Craos6518/AetherNet-IoT-Autonomous-Rover/docs/Estadistica/README.md

# Diario de Campo — Estadística (TS4D3)

> **Notebook:** `docs/Estadistica/notebook/EMA_Estadistica.ipynb` (canónico) · **Datasets:** `stats/Dataset/` (canónico 3.7 MB) ↔ `docs/Estadistica/Datasets/` (espejo) · **Análisis:** `stats/water_turbidity_analysis.py` + `stats/data/water_turbidity_report.json` · **Fritzing:** `docs/fritzing/AetherNet-P1-EMA-UNO-v1-breadboard.png`
> **Capa académica:** `docs/Estadistica/estadistica.md` (mapeo PDF TS4D3) + `docs/Estadistica/roadmap-estadistica.md` (búsquedas Google/datasheets) + `docs/Estadistica/backlog-estadistica.md` — este `docs/Estadistica/README.md` es el **diario de campo** (fotos/gráficos), no la teoría. Ver también `docs/Estadistica/Datasets/README.md` y `stats/Dataset/README.md`.

## Fotos / gráficos — checklist

- [ ] **EMA UNO breadboard** — ya existe `docs/fritzing/AetherNet-P1-EMA-UNO-v1-breadboard.png` + `ema-real-531.png`
- [ ] **Water US vs True** — ya existe `docs/fritzing/water_us_vs_true.png` (31.5k water_level_turbidity)
- [ ] **Water IR by Angle** — ya existe `docs/fritzing/water_ir_by_angle.png`
- [ ] **Alpha sweep 100×** — ya existe `docs/fritzing/alpha_sweep.png` (Monte Carlo `stats/experiments/alpha_sweep.py`)
- [ ] **KY-037 EMA** — `fotos/ky037-ema.png` — pendiente Sprint 4 (EST-03) — dejar `![GRAFICO PENDIENTE]`
- [ ] **T-Student boxplot** — `fotos/t-student-boxplot.png` — pendiente con datos PG reales Sprint 4

Si falta:

```markdown
![GRAFICO PENDIENTE](fotos/ky037-ema.png) — generar al cerrar EST-03 Sprint 4
```
