Craos6518/AetherNet-IoT-Autonomous-Rover/docs/Estadistica/Contraste_Admin_vs_Estadistica.docx

UNIVERSIDAD TECNOLÓGICA DE PEREIRA

Facultad de Ingenierías — Tecnología en Desarrollo de Software — 5º semestre

Contraste de Documentos
AetherNet IoT & Autonomous Rover

Administración de Proyectos (TS683) vs Estadística — Anteproyecto (TS4D3)
+ Integración de ambos Datasets al proyecto

Autor: | Andrés Felipe Martínez Henao (trabajo individual)
Fecha contraste: | 10 de septiembre de 2026 — Pereira, Risaralda
Doc A (Admin): | docs/Administracion de proyectos/Proyecto_AetherNet_Andres_Felipe_Martinez_Henao.docx (99 KB, 12 tablas, 671 párrafos)
Doc B (Estad.): | docs/Estadistica/Anteproyecto_AetherNet-3.docx (14 KB, 2 tablas, 8 secciones)
Datasets: | 36.500 filas, 3.7 MB — 31.500 turbidez + 5.000 gestos HC-SR04 (ver §5)
Repo: | github.com/Craos6518/AetherNet-IoT-Autonomous-Rover

Ambos documentos del mismo proyecto y autor — se complementan, no compiten. Este contraste cierra el gap de datasets externos que Administración resumía y Estadística detalla.

# Índice

1. Resumen ejecutivo ........................................................................ 3

2. Tabla comparativa global (12 dimensiones) ........................................ 3

3. Coherencias (6 puntos) ............................................................... 4

4. Complementos (qué aporta cada doc) ............................................... 5

5. Datasets — integración al proyecto (ambos) ........................................ 5

6. Gaps cerrados y acciones tomadas .................................................... 7

7. Recomendación de integración ........................................................ 7

8. Conclusión ................................................................................ 8

Anexo A — Ubicación y verificación ....................................................... 8

Anexo B — Referencias cruzadas .......................................................... 8

# 1. Resumen ejecutivo

El documento de Administración es el plan integral del sistema completo (app Kotlin/Compose + backend FastAPI/PostgreSQL/Mosquitto + 3 firmwares C++ + estadística + lowcode) bajo Scrum 4 sprints, con WBS, cronograma Gantt, matriz de 13 riesgos, costos ($176 HW / $1.176 con mano de obra) y 12 entregables. El Anteproyecto de Estadística es un zoom estadístico: valida solo el filtro EMA α=0.2 del Rover (seguridad anti-choque/caída del HC-SR04) con dos datasets externos de Kaggle — turbidez 31.500 filas y gestos HC-SR04 5.000 filas — midiendo reducción >85% y retardo de reacción. No compiten: el Anteproyecto es el detalle de OE-05 y EST-01..07 que Administración resume en 1 tabla y 1 anexo. Juntos cubren “qué se construye” (Admin) + “cómo se valida que el filtro sirve” (Estadística).

# 2. Tabla comparativa global

12 dimensiones — lectura: coherencias marcadas ✅, complementos sin contradicción.

Dimensión | Administración (Doc A) | Estadística (Doc B) | Lectura
Materia UTP | TS683 Administración de Proyectos | TS4D3 Estadística | Complementarias, mismo integrador
Alcance | Sistema completo (3 capas Edge→Gateway→Backend→App/Telegram) | Solo validación EMA HC-SR04 (seguridad Rover) | Estadística ⊂ Admin §3 OE-05 / §6 WBS 6.x
Título | AetherNet IoT & Rover — Plataforma 100% FOSS | Validación EMA con datos externos validados | Mismo nombre corto, distinto foco
Autor | Andrés Felipe Martínez Henao (solo) | Andrés Felipe Martínez Henao (individual) | ✅ Coherente
Estructura | 14 secciones, índice, portada UTP, header/footer | 8 secciones, sin WBS/costos | Admin=plantilla inst.; Estadística=guion TS4D3
Justificación | Nubes propietarias + falta integración + vacío FOSS + KPIs LAN | Ruido HC-SR04→riesgo choque; 531 muestras insuficientes→externos | Estadística profundiza HU-03 de Admin §2
Objetivo general | Desarrollar plataforma integral 100% FOSS con KPIs <50ms/<10ms/>85% en 4 sprints | Confirmar EMA α=0.2 reduce ruido consistente con datos reales externos | OG Estadística = criterio OE-05 Admin
O. específicos | 5 OE (infra, acceso MEGA, Rover fail-safe, app MQTT, EMA+t-Student) | 5 OE (describir turbidez/ángulo/nivel, EMA>85%, comparar turbidez, concluir α, medir retardo gestos) | OE-5 Admin se descompone en 5 OE Estadística
Pregunta inv. | Implícita HU-03 BDD: ¿EMA α=0.2 estabiliza HC-SR04? | Explícita: ¿EMA reduce ruido + reacciona rápido bajo turbidez/movimiento? | Estadística formula lo que Admin deja BDD
Metodología | Scrum 4 sprints + Kanban Projects 14 + CI arduino-cli + Gantt Mermaid | Descriptiva por grupos + EMA α=0.2 + error vs water_level + retardo gestos | Scrum=marco gestión; método estadístico=Sprint4
Datasets | Solo 531 internas + bench Monte Carlo 100× (no detallaba externos) | Dos externos Kaggle: 31.5k turbidez + 5k gestos HC-SR04 @20Hz | Gap cerrado hoy: 36.5k versionados (ver §5)
KPIs | 5 KPIs PRD + ≥95% tests, P95<2s | Mismo >85% + retardo (muestras hasta umbral) | ✅ Mismo umbral

Tabla 1 — Comparativa 12 dimensiones. Sin contradicciones bloqueantes.

# 3. Coherencias (lo que ya encaja)

Seis coherencias verificadas:

- α=0.2, KPI >85%, fórmula S_t = α·Y_t + (1-α)·S_{t-1} idéntica en ambos (stats/ema_filter.py:15 ↔ rover-uno.ino:259 ↔ Anteproyecto §5-6).
- Sensor HC-SR04 ultrasónico time-of-flight en ambos (Admin hardware-inventory.md Rover UNO; Estadística us_value / distancia_cm).
- Trabajo individual mismo autor sin conflicto “Equipo completo” de plantilla genérica.
- FOSS 100% RNF-3.1: Admin lo exige, Estadística lo respeta (CC BY-SA 4.0 con atribución + CC0 sin restricciones).
- Turbidez como proxy ambiental: Admin menciona ir_strength; Estadística lo usa como factor low vs high.
- 531 muestras internas reconocidas en ambos como limitación que motiva externos.

# 4. Complementos (qué aporta cada documento)

## Aporta Administración que falta en Estadística

- WBS, cronograma Gantt, riesgos 13 filas, costos, 12 entregables, CI/CD, app/backend/firmwares completos
- Visión 3 capas, protocolos (MQTT <50ms, RF <10ms, UART 38400, fail-safe 500ms), topics aethernet/#
- Retro solo, lecciones, plan sprints, Projects 14
- Anexos pines MEGA 44-46, Fritzing, evidencias mosquitto_sub/curl

## Aporta Estadística que faltaba en Administración

- Dos datasets externos concretos (31.5k + 5k) con 15+11 variables, diseño factorial, licencias, citas DOI
- Descriptiva por turbidez/ángulo/nivel + medición de retardo (50 frames @20Hz) — KPI rapidez no desglosado en Admin
- Pregunta explícita y 5 OE para t-Student y conclusión α
- Citas Kaggle + paper Ranieri et al. 2024 DOI 10.1016/j.engappai.2023.107235 y Marisol Gil DOI 10.34740/kaggle/dsv/16239431

Puente: Administración §6 WBS 6.1/6.4 y §9.1 citaban “bench 531 muestras + Monte Carlo 100×” sin origen externo — ahora se cubre con Datasets (§5).

# 5. Datasets — integración al proyecto (ambos)

Estado 10/09/2026: ✅ Ambos datasets ya versionados y espejados. No requieren descarga. 36.500 filas, 3.7 MB totales.

## 5.1 Ubicación en el repo

stats/Dataset/ (canónico — código lo importa) — 4 CSV idénticos en docs/Estadistica/Datasets/ (espejo entrega académica), diff=0. Verificación: wc -l = 36504 líneas (36.500 datos + 4 headers).

Directorio | Archivos | Filas | Tamaño | Licencia
stats/Dataset/ (canónico) | water-low/medium/high + gesture | 10.500×3 + 5.000 = 36.500 | 3.7 MB | CC BY-SA 4.0 + CC0
docs/Estadistica/Datasets/ (espejo) | (mismos 4 CSV, copia idéntica) | — idéntico — | — | —
stats/data/ (derivados) | water_turbidity_report.json, PNGs, ema-real-531.csv | 531 internas | 252 KB | Propio

Tabla 2 — Ubicación canónica y espejo.

## 5.2 Dataset 1 — Water level / turbidez (principal, volumen controlado)

Fuente: https://www.kaggle.com/datasets/caetanoranieri/water-level-identification-with-lidar — Caetano Ranieri, 2023-10-25, v1, ZIP 721 KB. Paper Ranieri et al. Engineering Applications of Artificial Intelligence, 127, 107235. DOI 10.1016/j.engappai.2023.107235. Licencia CC BY-SA 4.0 (atribución + share-alike, compatible RNF-3.1 FOSS).

Variable | Descripción | Tipo
id | Identificador consecutivo | Cuant. discreta
ir_value | LiDAR distancia infrarrojo | Cuant.
ir_strength | Intensidad LiDAR (proxy turbidez) | Cuant.
us_value | Ultrasónico crudo ≈ HC-SR04 — variable EMA | Cuant.
acc_*, gyr_* (9 ejes) | IMU aceleración/giroscopio | Cuant.
angle | Inclinación 0.0/2.5/5.0/7.5/10.0° | Cuant. discreta
water_level | Nivel real 50-350mm (verdad terreno) | Cuant. discreta
turbidity | low/medium/high (por archivo) | Cual. ordinal

Tabla 3 — 15 columnas Dataset 1 (8 mostradas). Diseño 3×5×7×300 = 31.500 balanceadas. Relevancia: us_value≈HC-SR04 rover-uno.ino:259, permite error vs water_level y reducción >85%.

## 5.3 Dataset 2 — Hand Gesture (complementario, mismo HC-SR04 + movimiento real)

Fuente: https://www.kaggle.com/datasets/marisolgil/hand-gesture-dataset — Marisol Gil Valenzuela (Univ. Sonora), 2026, DOI 10.34740/kaggle/dsv/16239431. Licencia CC0 1.0 Dominio público (sin restricciones, FOSS). Archivo gesture_dataset.csv 5.000 filas = 5 gestos ×50 frames ×20Hz (~2.5s por gesto). Único con serie temporal real.

Variable | Descripción | Tipo
frame_id | 0-49 por gesto | Cuant. discreta
timestamp_ms | Marca tiempo ms (50ms @20Hz) | Cuant.
sujeto_id | Persona (mgv1...) | Cual. nominal
mano | derecha/izquierda | Cual. nominal
velocidad_subjetiva | lenta/normal/rápida | Cual. ordinal
gesto | acercar/alejar/estático cerca/lejos/ninguno | Cual. nominal
distancia_cm | HC-SR04 cm — misma unidad Rover | Cuant.
velocidad_cm_s | Derivada distancia | Cuant.
tendencia | estable/subiendo/bajando | Cual. ordinal
valido | 1 válido / 0 no válido | Cual. binaria

Tabla 4 — 11 columnas Dataset 2. Complemento: mide retardo EMA ante cambio súbito (OE-5), que dataset 1 no puede (mediciones estáticas).

## 5.4 Complemento entre ambos

Aspecto | Dataset 1 (turbidez) | Dataset 2 (gestos)
Sensor | Genérico ultrasónico | HC-SR04 idéntico AetherNet
Volumen | Grande 31.5k controlado | Mediano 5k temporal
Movimiento | No (300 repeticiones estáticas) | Sí (50 frames @20Hz)
Evalúa >85% | ✅ robusto | ✅ mismo sensor
Evalúa retardo | ❌ | ✅ rapidez EMA

Tabla 5 — Complemento: 1 aporta volumen controlado, 2 aporta mismo sensor + movimiento temporal (anteproyecto §3).

Fichas completas + citas DOI en docs/Estadistica/Datasets/README.md y stats/Dataset/README.md.

# 6. Gaps cerrados y acciones tomadas (10/09/2026)

Gap detectado | Acción
Admin no detallaba datasets externos (solo 531 internas) | Versionados ambos Kaggle en stats/Dataset/ + espejo docs/Estadistica/Datasets/ con READMEs
gesture_dataset.csv untracked (?? git status) | git add incluido próximo commit — 5.000 filas verificadas, copia idéntica en ambos directorios
stats/Dataset/README.md solo turbidez | Actualizado a “Datasets — Validación externa” con Dataset 2 (CC0, 11 vars, uso retardo)
Docente necesita datasets en docs/Estadistica | Creado docs/Estadistica/Datasets/ espejo + README.md con fichas, tablas y citas DOI
Falta contraste formal | Creado CONTRASTE_Admin_vs_Estadistica.md + este docx
Trazabilidad cruzada | Este contraste enlaza OE-05/EST-01..07 ↔ 5 OE ↔ ema_filter.py:15/rover-uno.ino:259 ↔ water_turbidity_analysis.py

Tabla 6 — Gaps cerrados 10/09/2026.

# 7. Recomendación de integración

- 1. En Administración §6 WBS 6.3 y §9.1: añadir nota “Validado con datasets externos 31.5k (turbidez) + 5k (gestos HC-SR04) — ver docs/Estadistica/Datasets/README.md y stats/Dataset/README.md”.
- 2. En Administración §14 Anexos: añadir Anexo G “Datasets externos” con las dos fichas de §5 de este contraste.
- 3. En Estadística Sprint4: ejecutar python3 stats/water_turbidity_analysis.py y gestos → water_turbidity_report.json + PNGs y reportar reducción % y retardo en notebooks/EMA_Estadistica.ipynb §7c/7d.
- 4. En informe final EST-07: incluir citas CC BY-SA 4.0 y CC0 (ver §5) y referenciar stats/Dataset/ y docs/Estadistica/Datasets/ como fuentes.

Sin estas 4 líneas, ambos docs quedan consistentes pero desconectados; con ellas, Administración absorbe evidencia externa y Estadística deja de ser “ejercicio aislado”.

# 8. Conclusión

No hay contradicción. Administración es el mapa y Estadística es la brújula del filtro. El contraste muestra que el Anteproyecto no corrige a Administración: lo completa en el punto más riesgoso (R-03 EMA mal calibrado). Con ambos datasets ya integrados (36.500 filas, 3.7 MB, HC-SR04 idéntico incluido), el proyecto puede sostener ante evaluador: “EMA α=0.2 no solo simula 89% en 531 muestras internas, sino que se valida en 31.5k medidas controladas y 5k movimientos reales del mismo sensor, con licencias FOSS y diseño balanceado”. Próximo paso: commit que incluya docs/Estadistica/Datasets/*.csv + stats/Dataset/gesture_dataset.csv + READMEs + este contraste, y referencia cruzada en Proyecto_AetherNet...docx Anexo G.

# Anexo A — Ubicación y verificación

stats/Dataset/ canónico (código) y docs/Estadistica/Datasets/ espejo (entrega). Verificación: wc -l = 36504 líneas (36.500 datos + 4 headers); python3 stats/water_turbidity_analysis.py --check valida 31.500 balanceadas (3×5×7×300). Ambos espejos diff=0.

Comandos:

wc -l stats/Dataset/*.csv docs/Estadistica/Datasets/*.csv
# 5001 gesture + 10501×3 water = 36504 líneas
python3 stats/water_turbidity_analysis.py --check
jupyter lab notebooks/EMA_Estadistica.ipynb # §7c turbidez, §7d gestos

# Anexo B — Referencias cruzadas

- docs/prd.md §5 KPIs, §6 LAN — docs/requirements.md §2-3 RF/RNF/HU-03 — docs/sprints.md, docs/backlog.md EST-01..07
- docs/hardware-inventory.md (HC-SR04, TCRT5000, KY-008) — docs/architecture.md §3-4 (EMA, t-Student) — docs/risk-register.md R-03, R-12
- stats/ema_filter.py:15, rover-uno.ino:259, stats/water_turbidity_analysis.py:1, notebooks/EMA_Estadistica.ipynb §7c/7d
- Kaggle turbidez: kaggle.com/datasets/caetanoranieri/water-level-identification-with-lidar — CC BY-SA 4.0 — DOI 10.1016/j.engappai.2023.107235
- Kaggle gestos: kaggle.com/datasets/marisolgil/hand-gesture-dataset — CC0 — DOI 10.34740/kaggle/dsv/16239431
- stats/Dataset/README.md (canónico) + docs/Estadistica/Datasets/README.md (espejo) + docs/Estadistica/CONTRASTE_Admin_vs_Estadistica.md (este contraste)

Universidad Tecnológica de Pereira Tecnología en Desarrollo de Software Facultad de Ingenierías
