Craos6518/AetherNet-IoT-Autonomous-Rover/docs/fritzing/AetherNet-P1-EMA-UNO-v1-breadboard.png

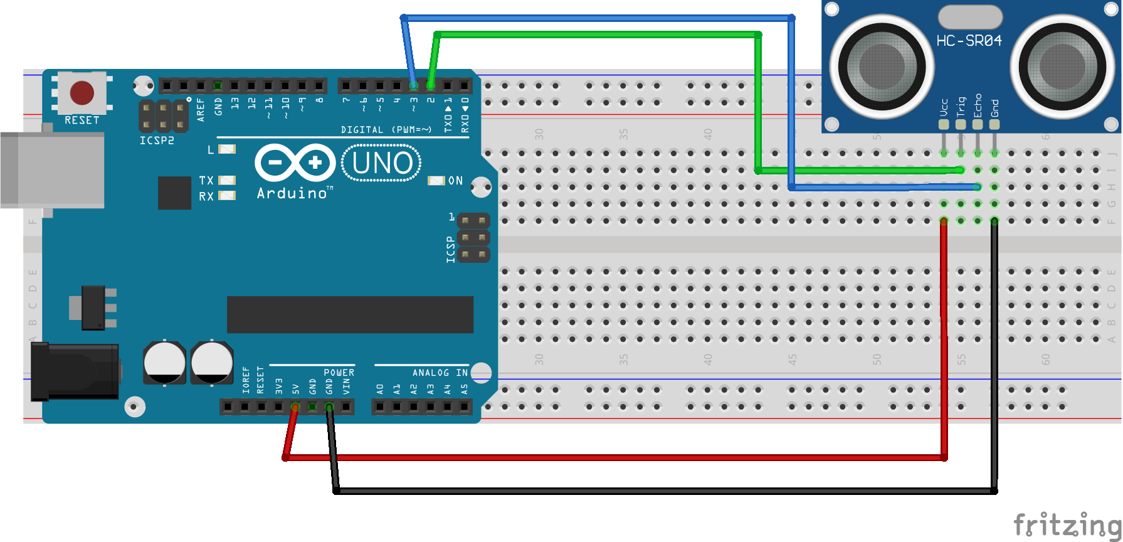
docs/fritzing/AetherNet-P1-EMA-UNO-v1-breadboard.png
