Craos6518/AetherNet-IoT-Autonomous-Rover/docs/fritzing/AetherNet-P2-RF-Link-v1-breadboard.png

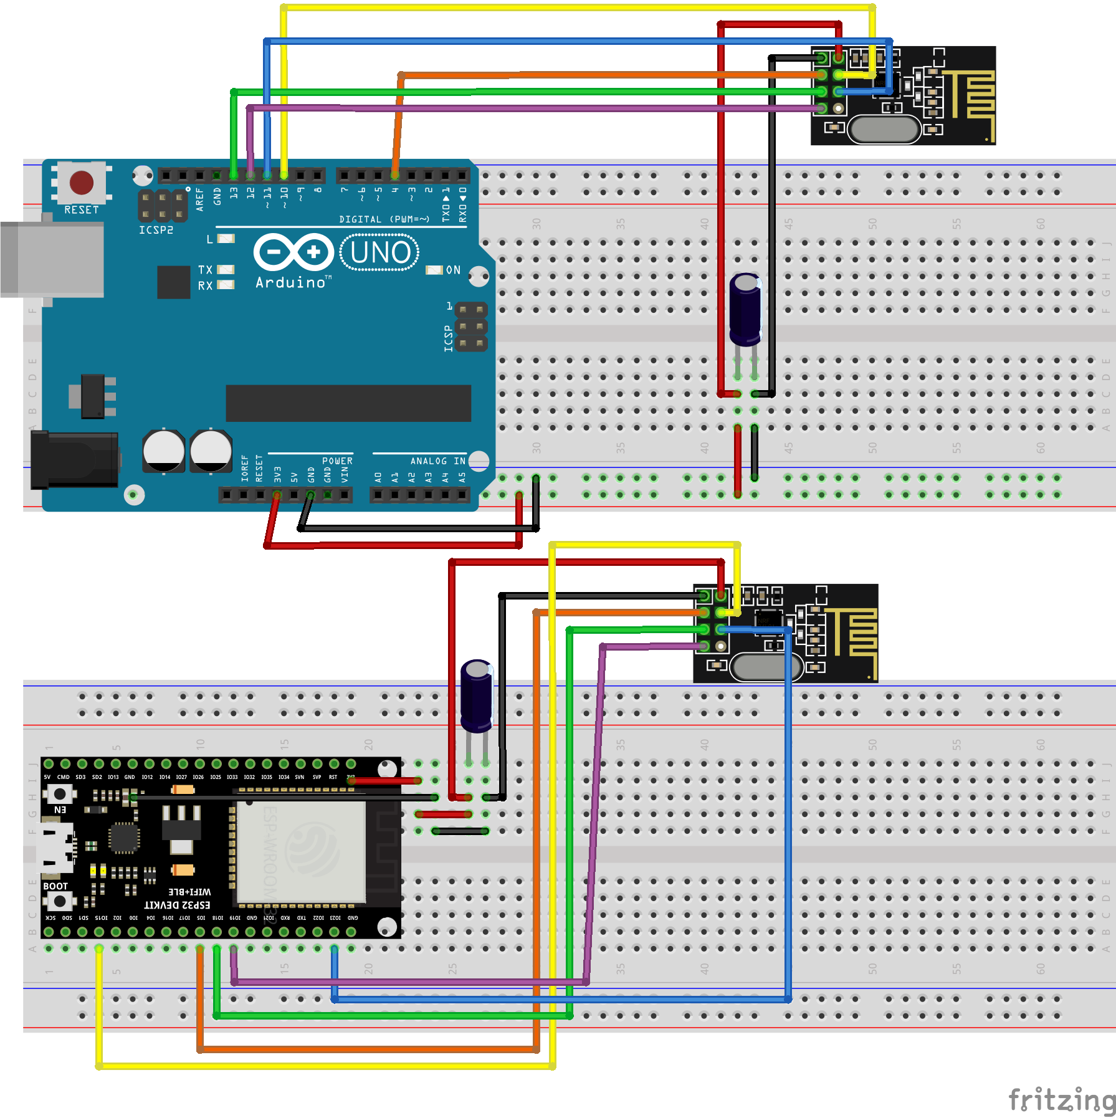
docs/fritzing/AetherNet-P2-RF-Link-v1-breadboard.png
