Craos6518/AetherNet-IoT-Autonomous-Rover/docs/fritzing/AetherNet-P3-MEGA-Cerrojo-v1-breadboard.png

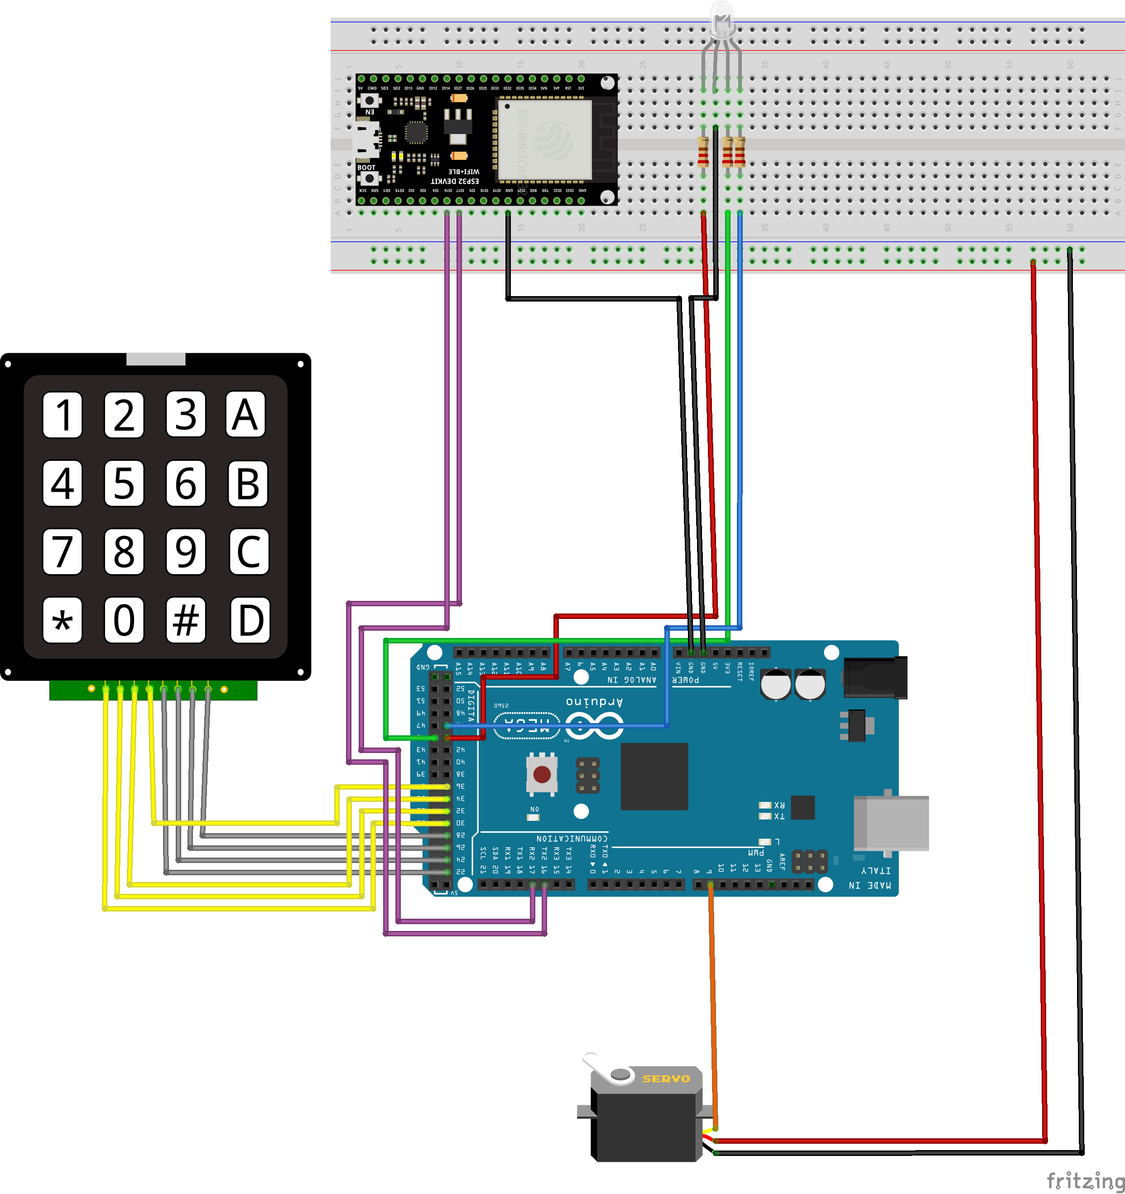
docs/fritzing/AetherNet-P3-MEGA-Cerrojo-v1-breadboard.png
