Craos6518/AetherNet-IoT-Autonomous-Rover/docs/fritzing/AetherNet-P4-Rover-v1-breadboard.png

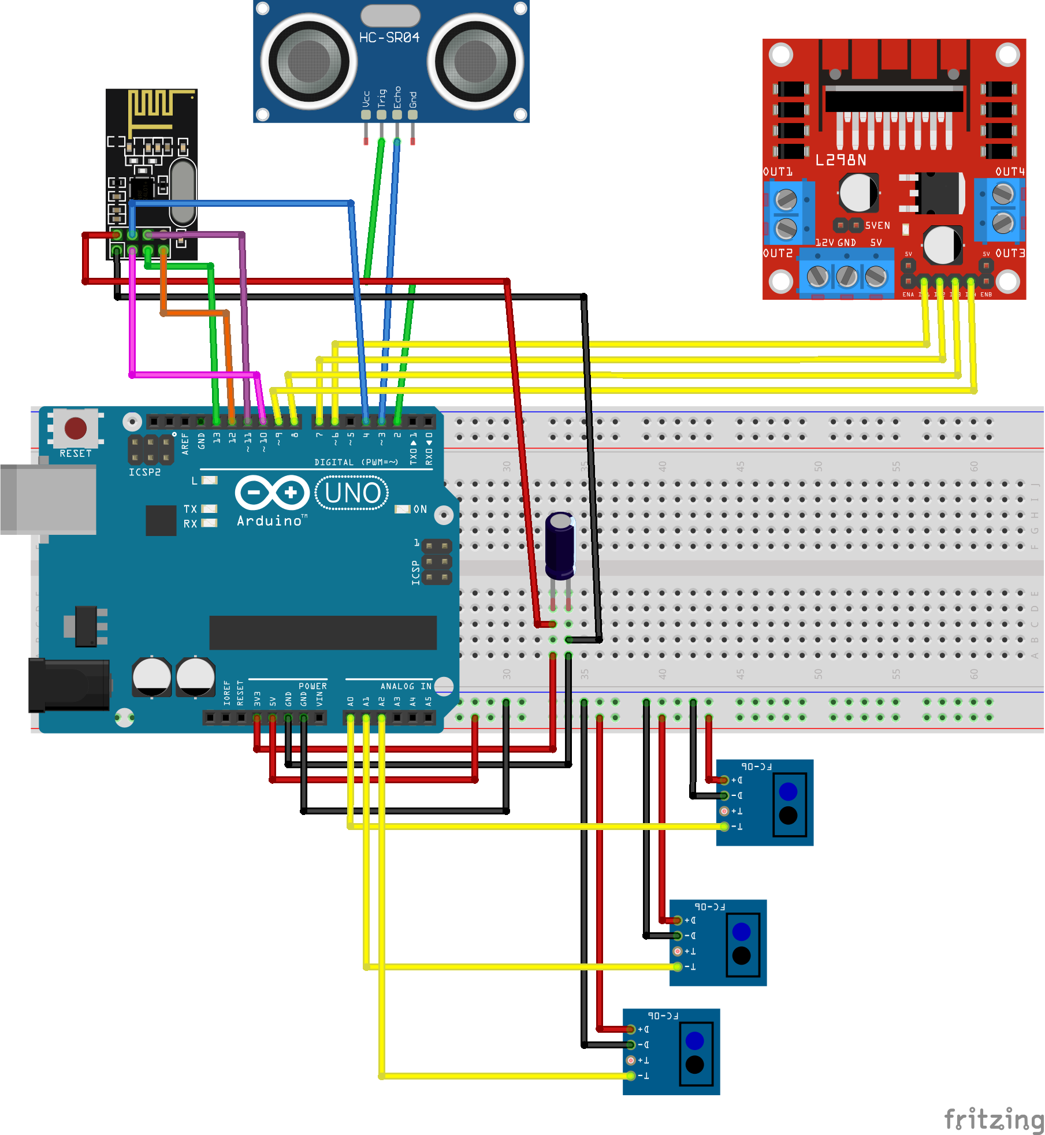
docs/fritzing/AetherNet-P4-Rover-v1-breadboard.png
