Craos6518/AetherNet-IoT-Autonomous-Rover/docs/fritzing/AetherNet-P5-Laser-v1-breadboard.png

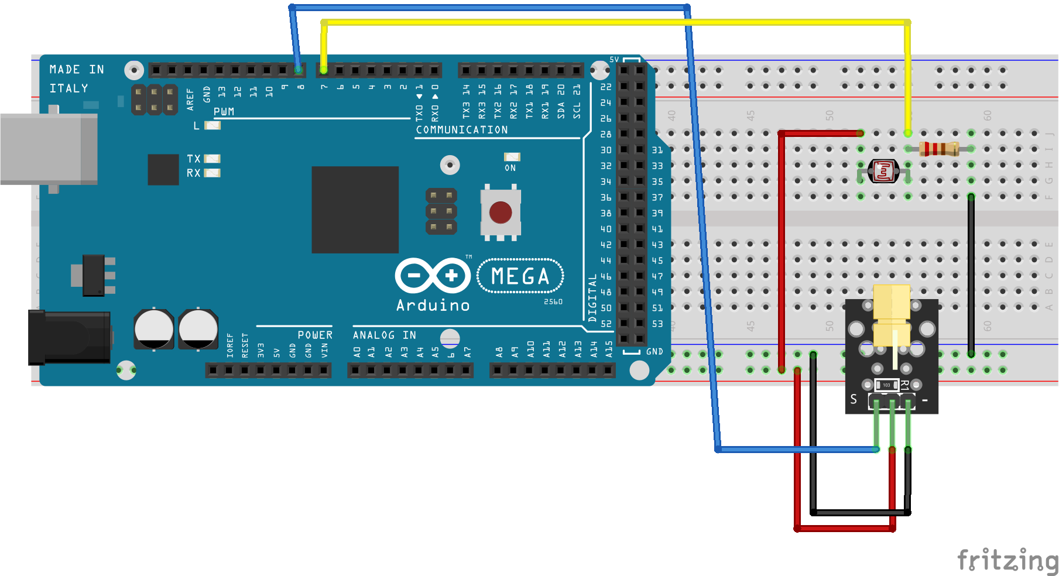
docs/fritzing/AetherNet-P5-Laser-v1-breadboard.png
