Craos6518/AetherNet-IoT-Autonomous-Rover/docs/fritzing/AetherNet-P6-Ambiental-v1-breadboard.png

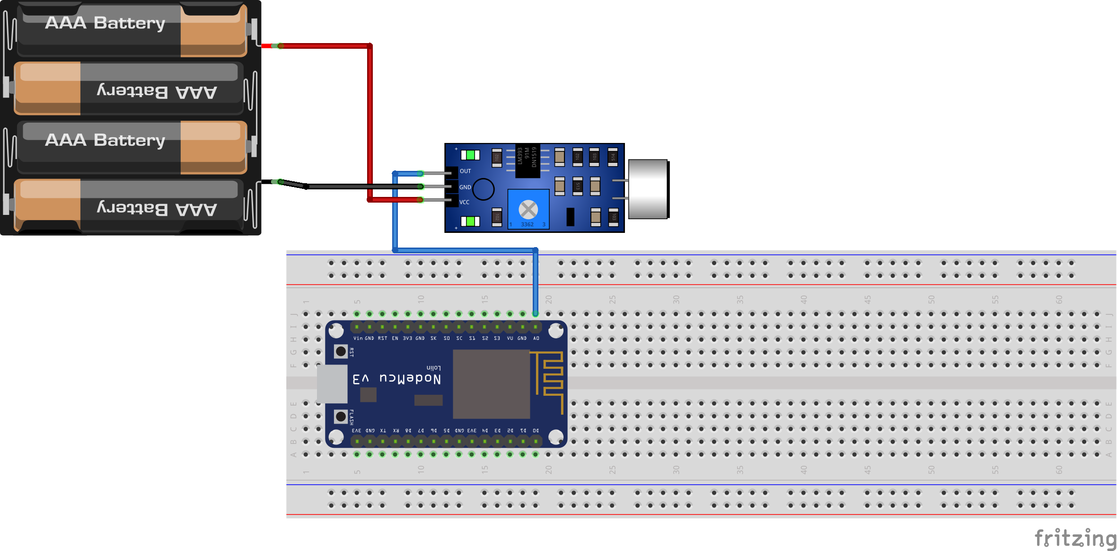
docs/fritzing/AetherNet-P6-Ambiental-v1-breadboard.png
