Craos6518/AetherNet-IoT-Autonomous-Rover/docs/fritzing/AetherNet-P7-Compacto-v1-breadboard.png

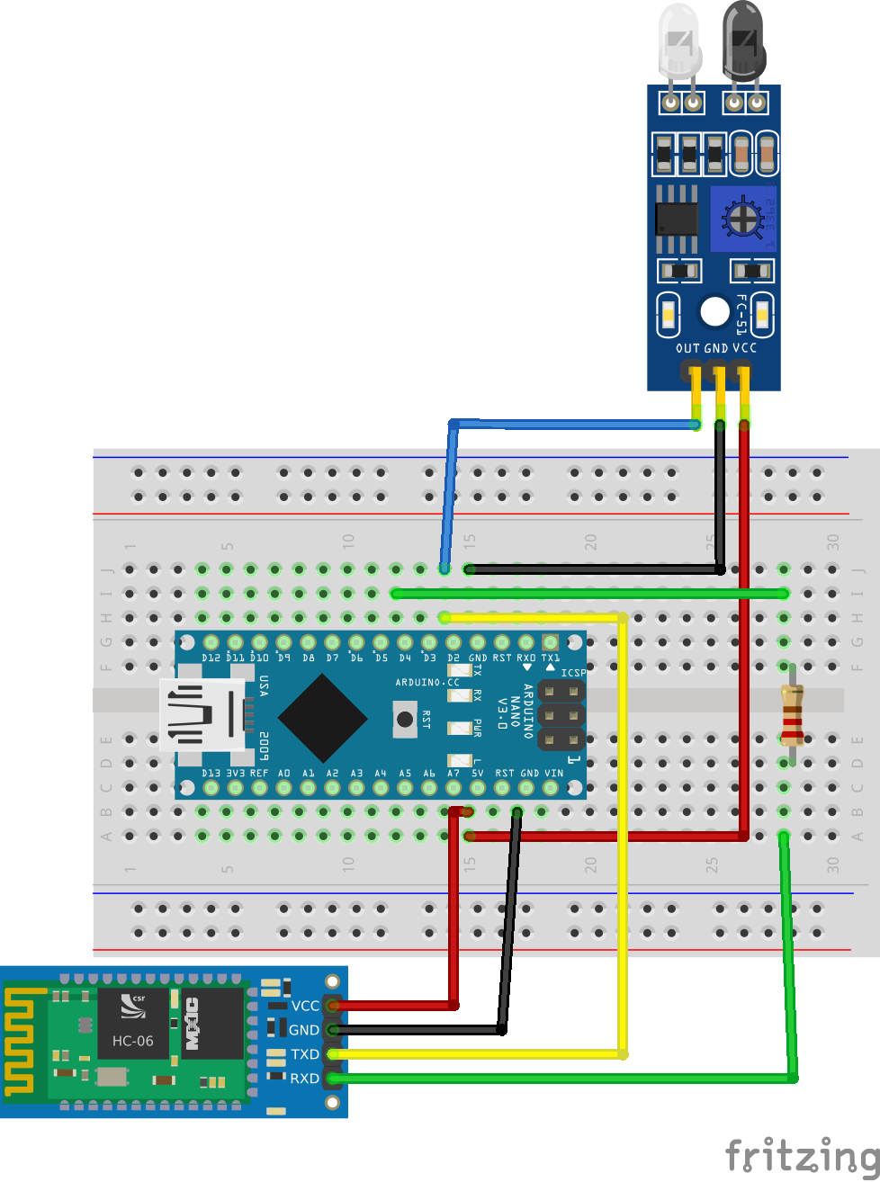
docs/fritzing/AetherNet-P7-Compacto-v1-breadboard.png
