Craos6518/AetherNet-IoT-Autonomous-Rover/docs/fritzing/alpha_sweep.png

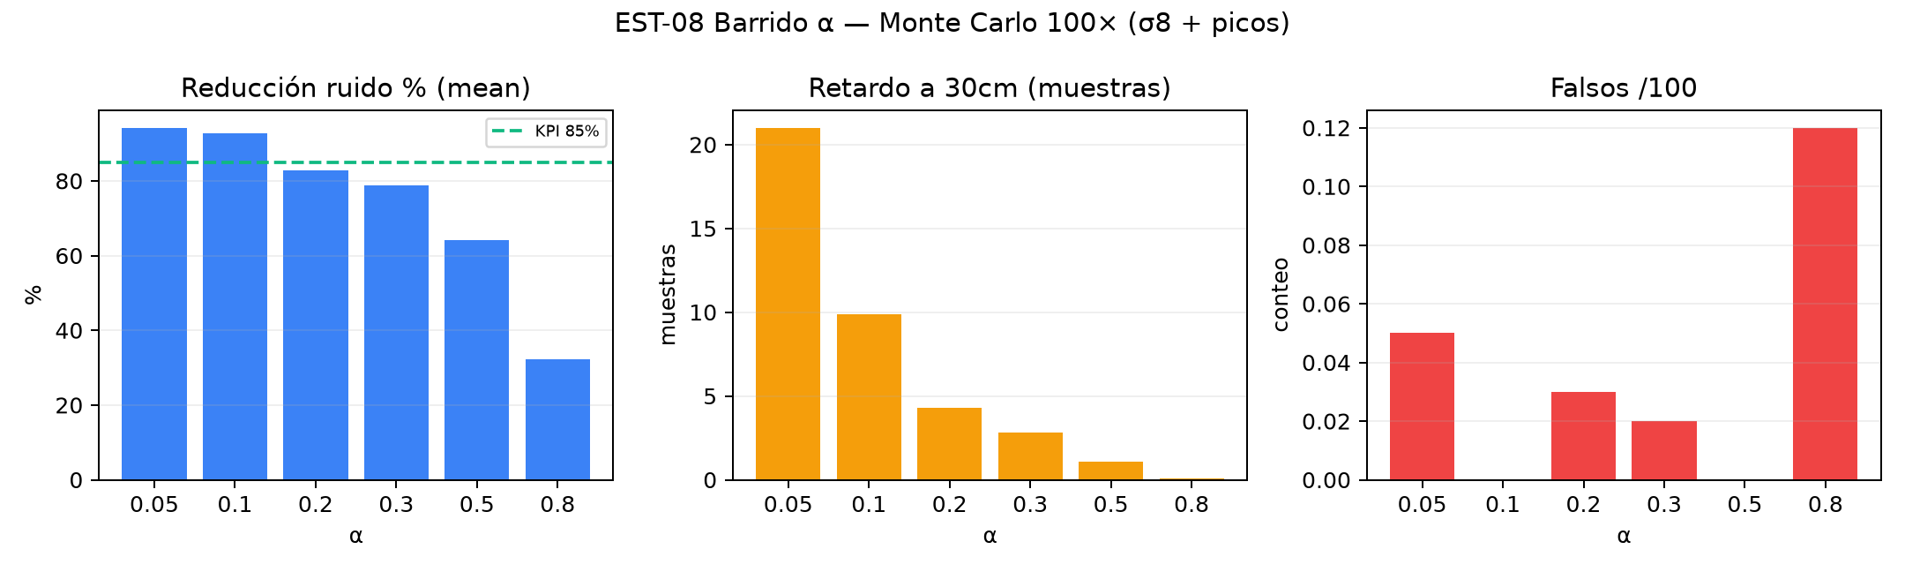
docs/fritzing/alpha_sweep.png
