Craos6518/AetherNet-IoT-Autonomous-Rover/docs/fritzing/ema-compare.png

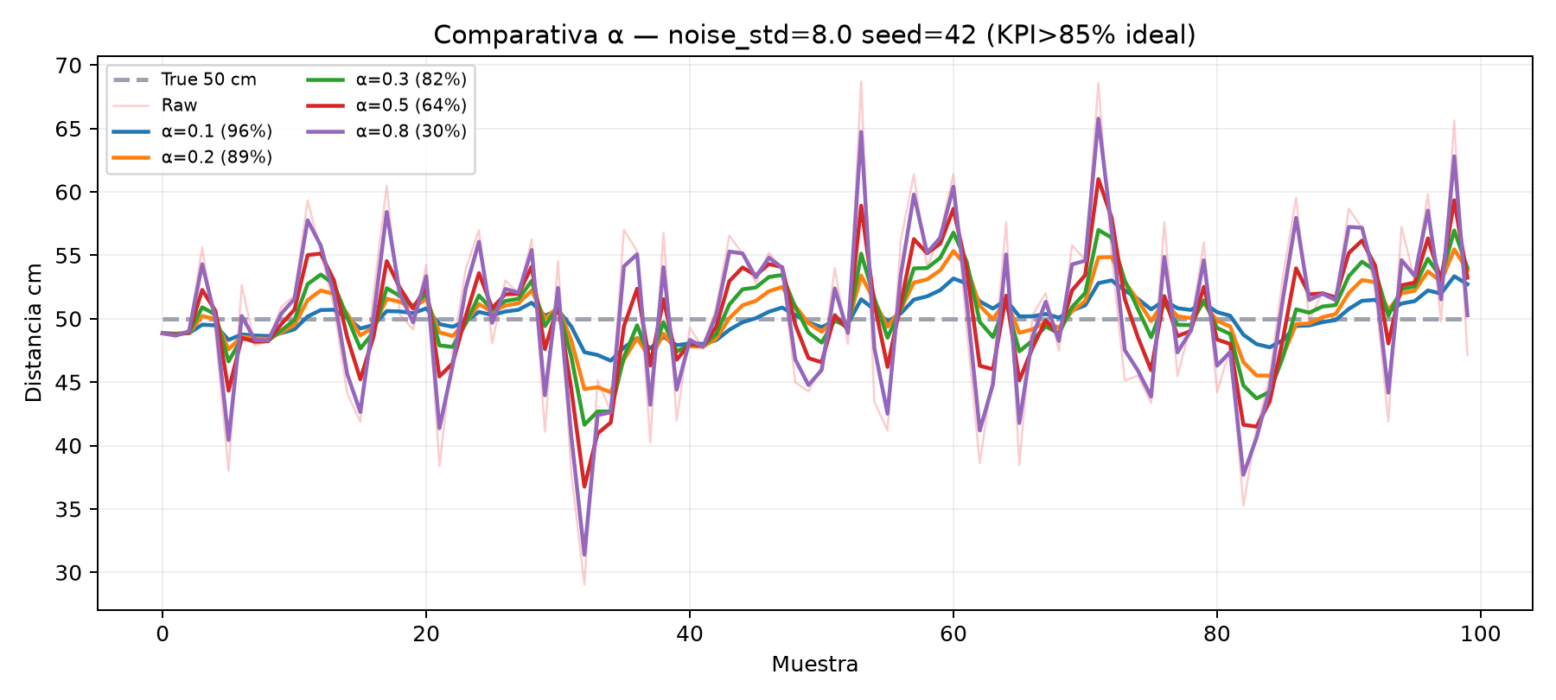
docs/fritzing/ema-compare.png
