Craos6518/AetherNet-IoT-Autonomous-Rover/docs/fritzing/ema-demo.png

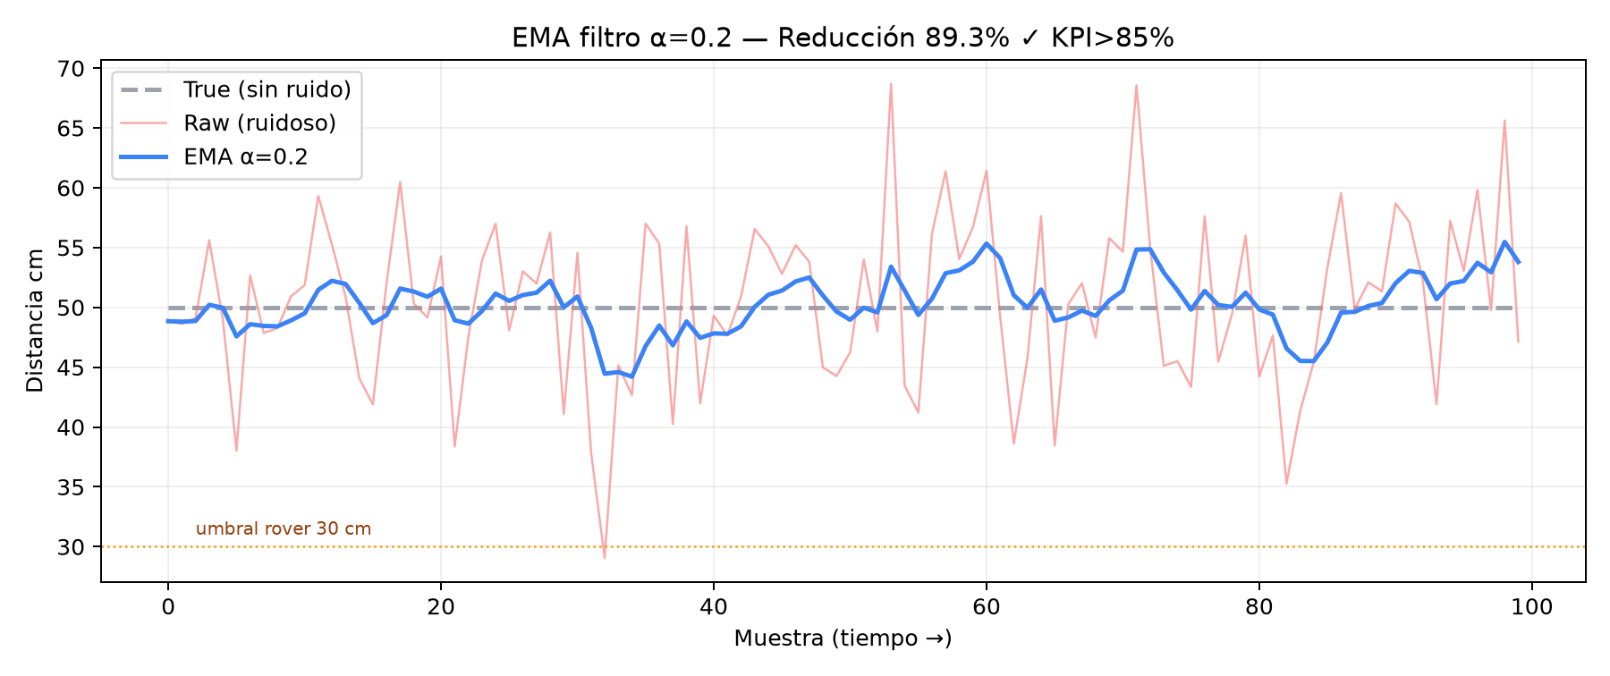
docs/fritzing/ema-demo.png
