Craos6518/AetherNet-IoT-Autonomous-Rover/docs/fritzing/ema-obstacle.png

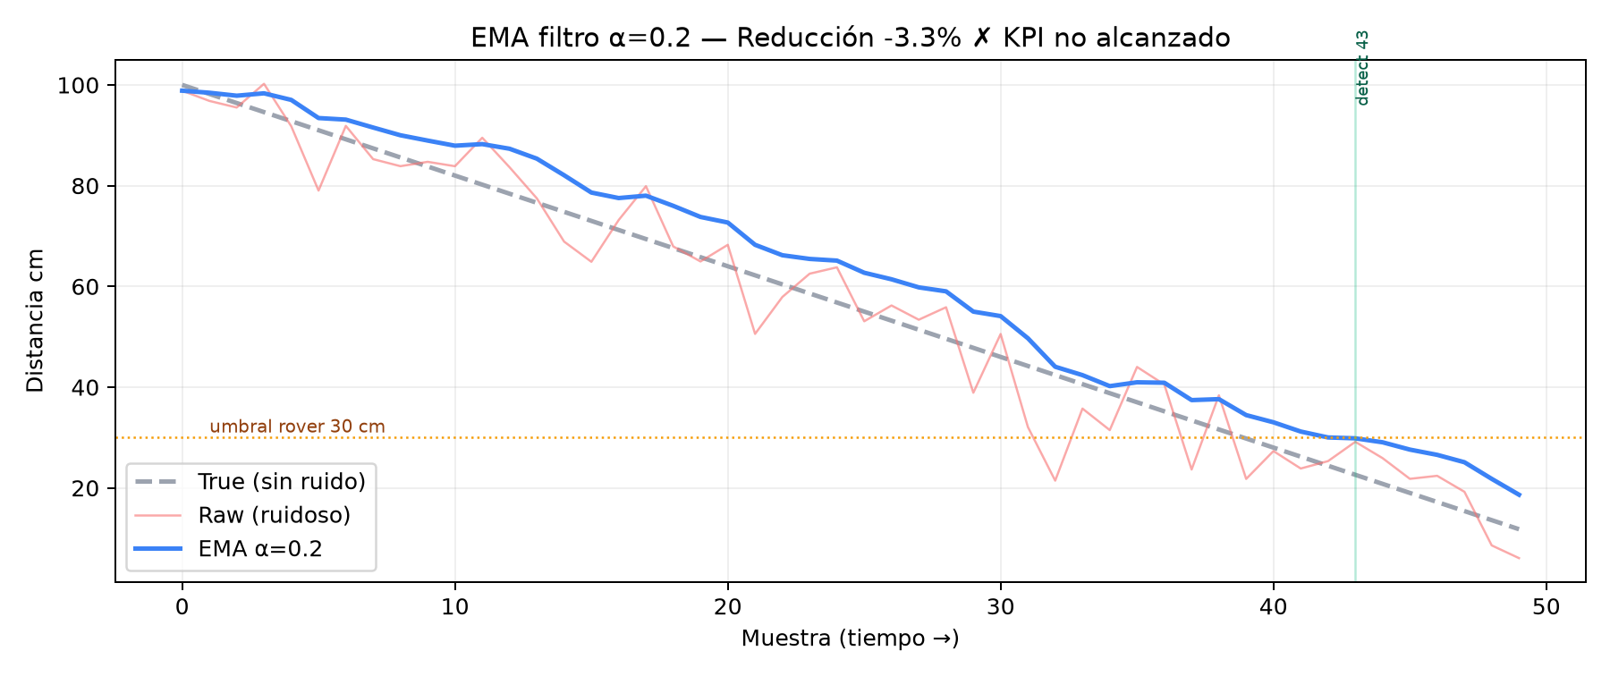
docs/fritzing/ema-obstacle.png
