Craos6518/AetherNet-IoT-Autonomous-Rover/docs/fritzing/ema-real-531.png

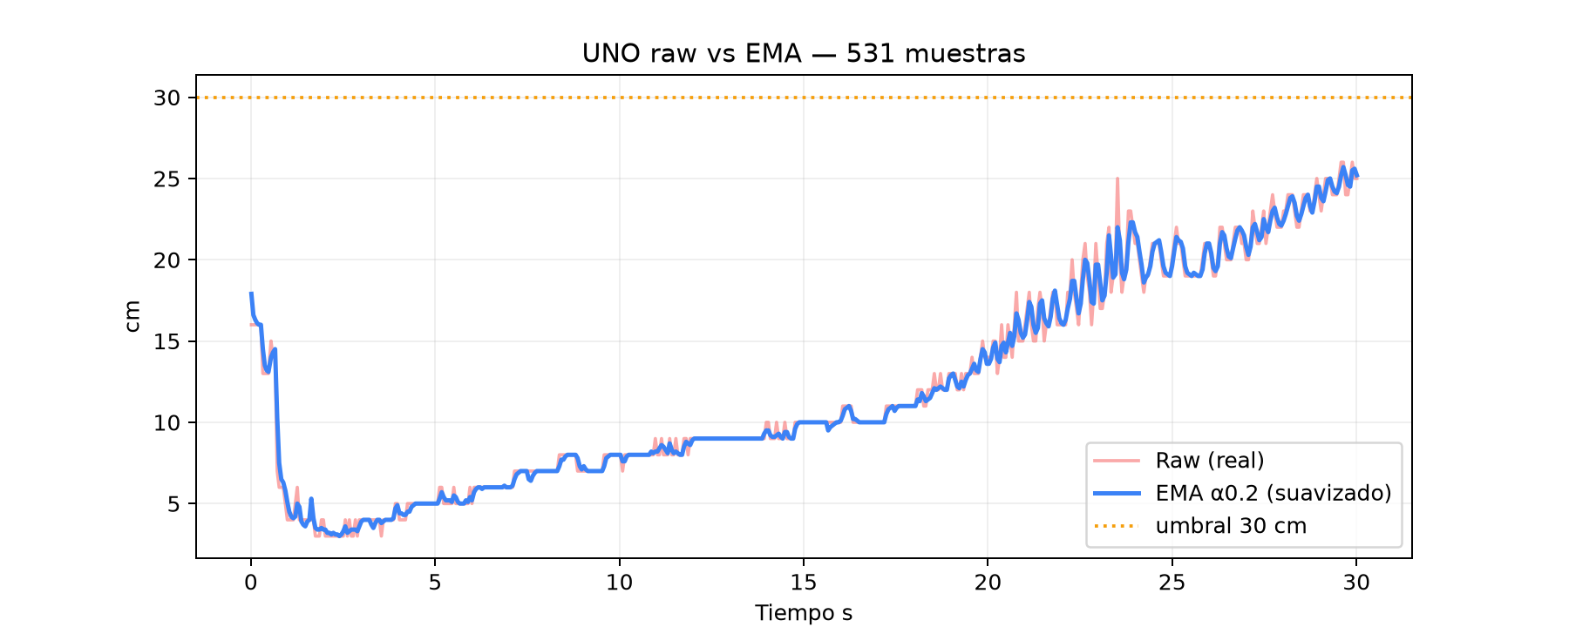
docs/fritzing/ema-real-531.png
