Craos6518/AetherNet-IoT-Autonomous-Rover/docs/fritzing/gesture_boxplot.png

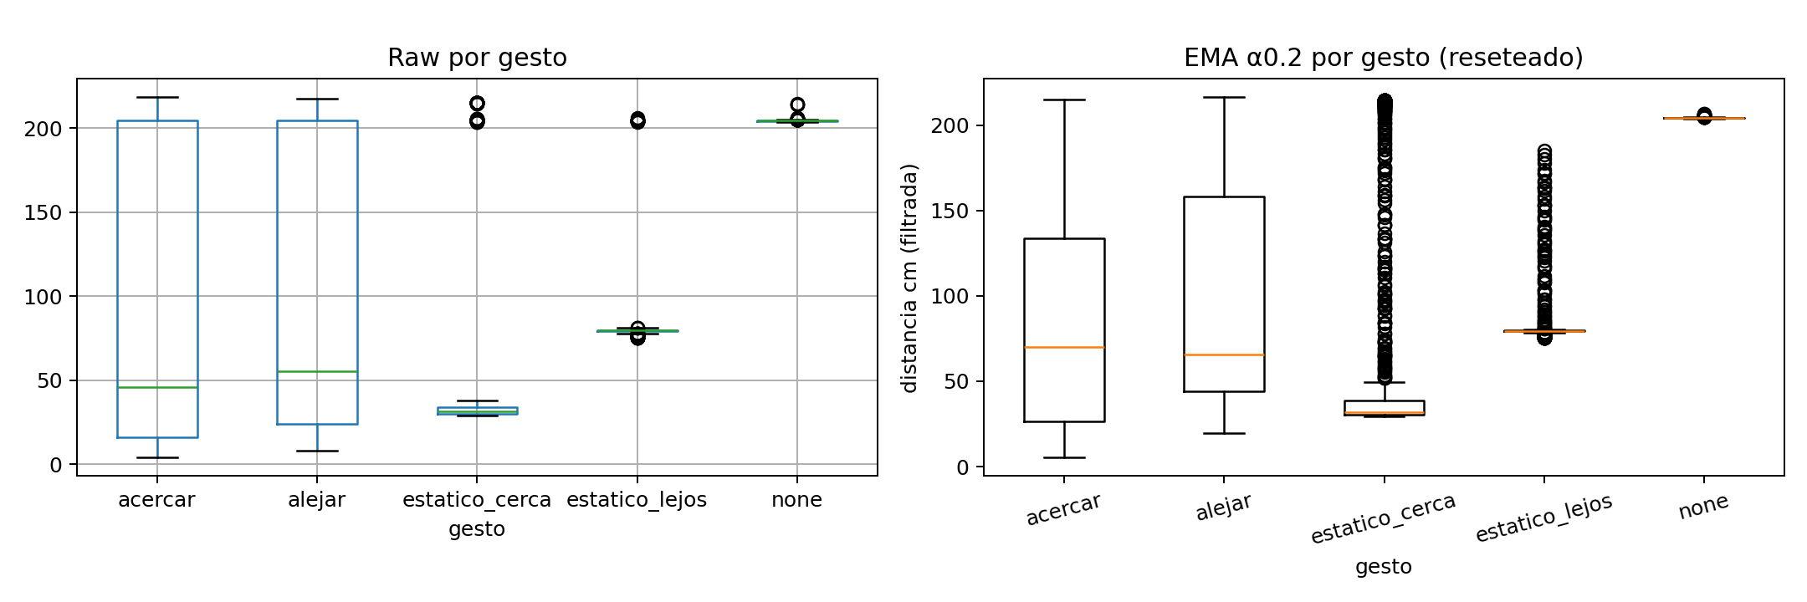
docs/fritzing/gesture_boxplot.png
