Craos6518/AetherNet-IoT-Autonomous-Rover/docs/fritzing/gesture_ema_series.png

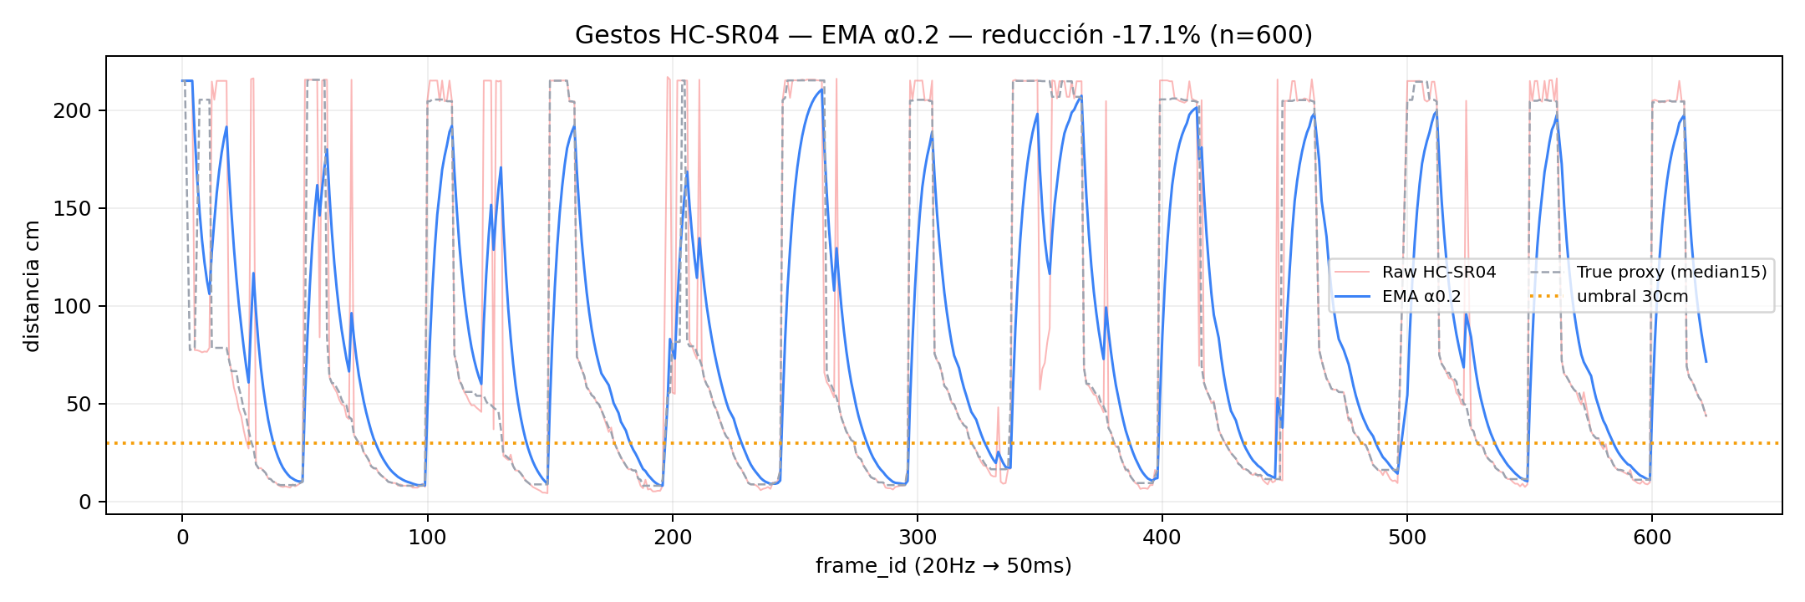
docs/fritzing/gesture_ema_series.png
