Craos6518/AetherNet-IoT-Autonomous-Rover/docs/fritzing/water_us_vs_true.png

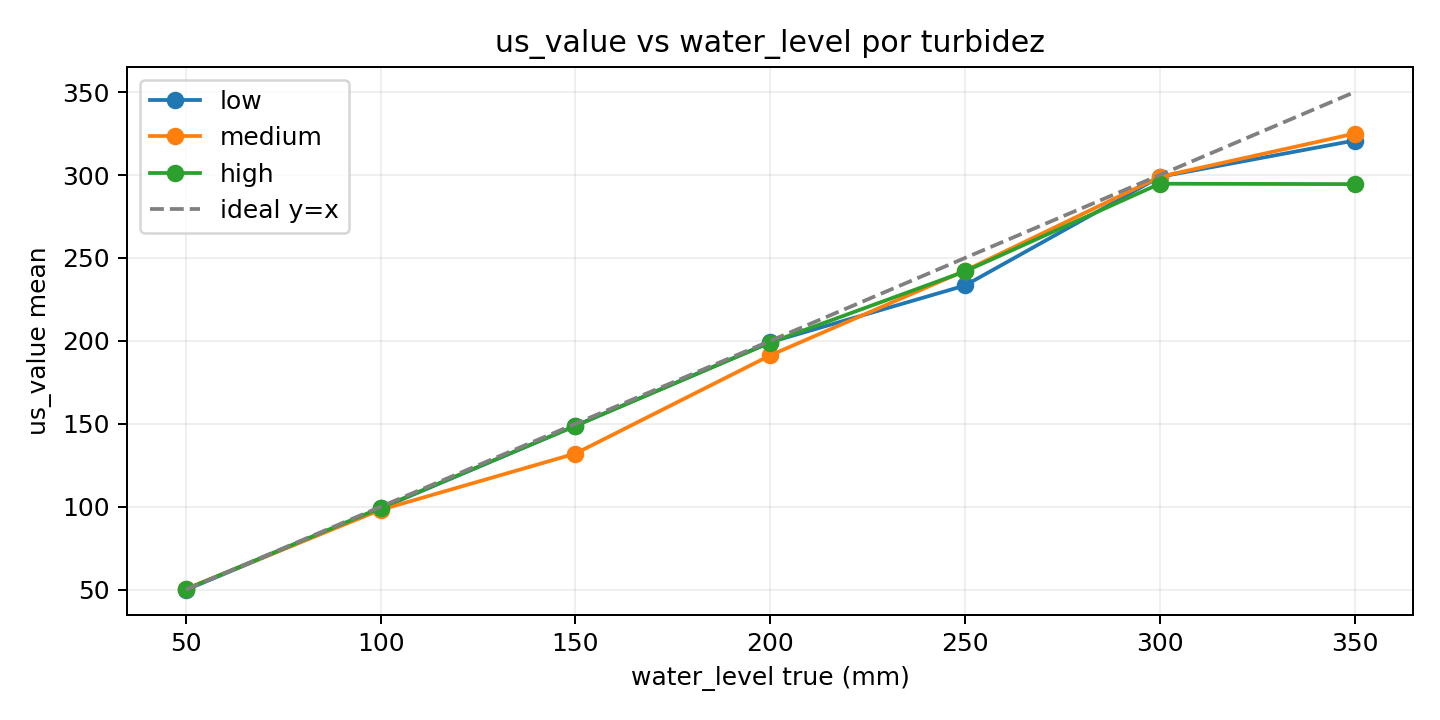
docs/fritzing/water_us_vs_true.png
