Craos6518/AetherNet-IoT-Autonomous-Rover/stats/data/ema_dual_summary.png

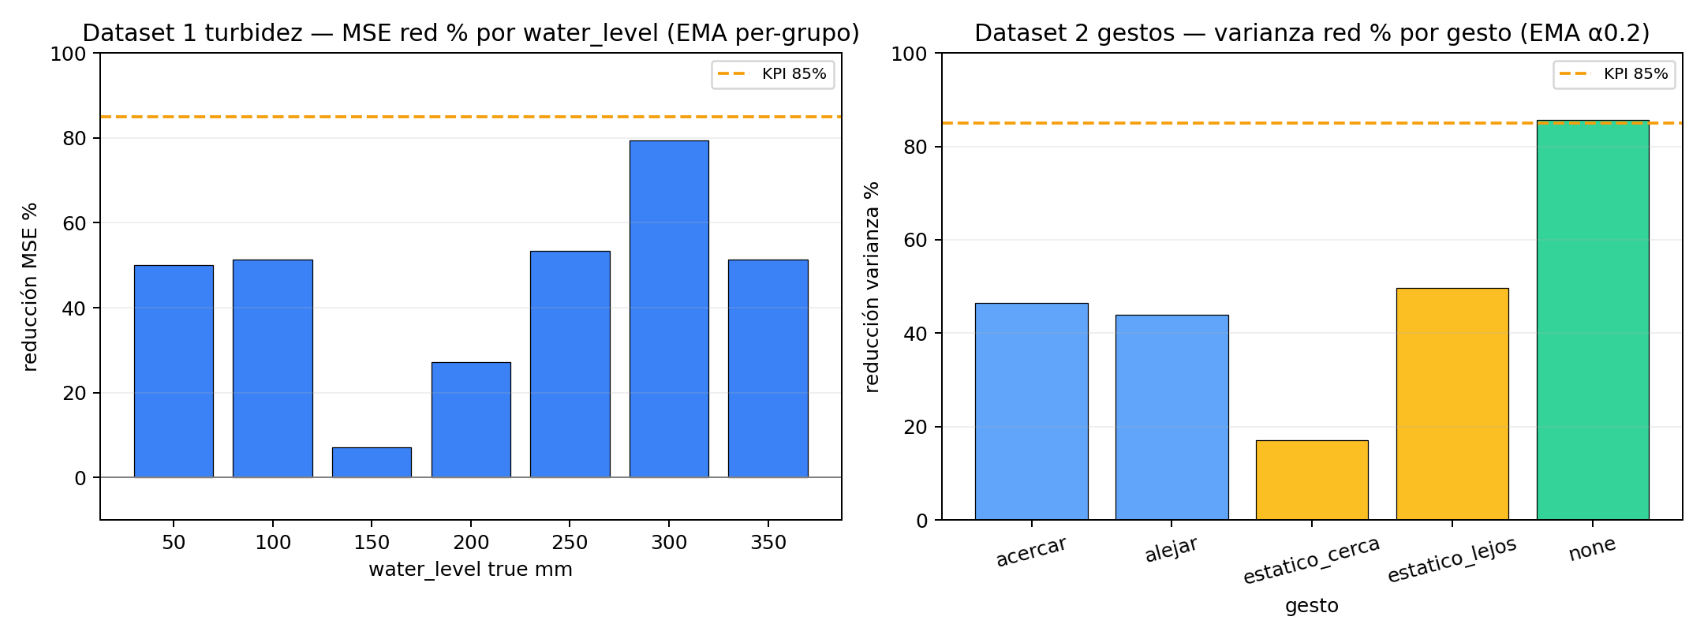
stats/data/ema_dual_summary.png
