Craos6518/AetherNet-IoT-Autonomous-Rover/(list of files, drawings)

Other design files:
docs/fritzing/mega-cerrojo-v1.fzz
