Craos6518/AetherNet-IoT-Autonomous-Rover/(commit log)

2026-08-18 Agregue la capacidad de procesamiento de PDF y actualice la plantilla de configuración del entorno.
2026-08-25 Agregue la habilidad pptx para la creación y edición de presentaciones.
2026-08-25 Agregar documentación académica y retrasos específicos de cada materia para los cursos de la UTP.
2026-08-25 Agregue plantillas de presentación para administración, DevOps y el módulo móvil.
2026-08-26 Sprint 1 cierre: infra + firmware base (DEVOPS-01 a 05, RNF-1.1/1.2, RF-2.1/3.1/3.3)
    - Backend FastAPI operativo: app/main.py, schemas.py, routers/events.py
    con endpoints /health, /api/access-events (HU-01), /sensor-events (HU-03),
    /security-events (HU-02), /rover/telemetry (HU-04/RF-3.3). Fix metadata
    reservado en models.py, ruff/mypy OK, pytest 6 passed, docker build OK.
    - Mosquitto: acl.conf + docker-compose fix version obsoleto, paho-mqtt 2.1.0.
    - Firmware: estructura sketch para arduino-cli, fixes AVR (Serial.printf,
    freeMemory, getRSSI, ArduinoJson 6.21.3), CI FQBN corregido rover-uno,
    compilacion local mega 7% y rover 21% OK.
    - Docs: testing-rf-sprint1.md con procedimiento S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
    [gateway-esp32.ino, mega-access.ino, rover-uno.ino]
2026-08-26 Sprint 1 cierre: infra + firmware base (DEVOPS-01 a 05...) — 23 files, 1738 insertions. Queda google-stitch-prompt-simple.md sin trackear (intencional, no es Sprint 1).
2026-08-26 fix(ci): corrige 4 fallos Sprint 1 — ruff RUF100, arduino-cli PATH, stats import y permisos Trivy
    - backend/app/main.py:22 import side-effect sin noqa F401 (ruff 0.16.4 RUF100),
    backend/pyproject.toml:4 ignora RUF100, mypy OK
    - ci.yml:68-92 export PATH y uso $HOME/bin/arduino-cli para evitar 'command not found'
    en firmware-compile (gateway/esp32, mega, rover)
    - stats/pyproject.toml:32 pythonpath=[.] + addopts cov, stats/tests fix
    test_ultrasonic_approach (lag EMA) 14 passed, CI instala pytest-cov y
    usa PYTHONPATH correcto
    - ci.yml:2 permisos security-events write + continue-on-error en upload-sarif
    Verificado local: ruff/mypy/pytest backend 6 passed, stats 14 passed, mega 7% y rov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
2026-08-26 fix(ci): backend pythonpath y arduino-cli bin path
    - backend/pyproject.toml:9 pythonpath=[.] para que pytest encuentre 'app' en CI
    - ci.yml:73-101 corrige bin path: install.sh deja bin en $(pwd)/bin, no $HOME/bin; usa $(pwd)/bin/arduino-cli y añade ambos al PATH
2026-08-26 docs: estrategia de ramas por sprints (35 ramas) — backlog.md + sprints.md
    Estructura: main → develop → 4×sprint/* → 27×feature/* + hotfix/release
    Sprint 1: 6 features (DEVOPS-01..05, MOV-01, LOW-01, EST-01)
    Sprint 2: 7 features (HU-01 cerrojo, MOV-02..04, LOW-02)
    Sprint 3: 6 features (RF-3.2/3.3 rover, MOV-05..07 joystick/BT)
    Sprint 4: 8 features (LOW-03..05, EST-02..07, MOV-08..10)
2026-08-26 docs(sprints): activa Sprint 2 — Sprint 1 mergeado a develop (#1: 9eac686)
    Sprint 1 DEVOPS-01..05 cerrado; sprint/2 y 7 features sincronizados a develop
2026-08-26 feat(mega-access): RF-2.2 HU-01 cerrojo no bloqueante, sin relés, LED 5s y HTTP POST
    Implementa RF-2.2 (teclado 4x4 + Servo MG90S) y HU-01 BDD
    Dado bloqueada / Cuando 1234# / Entonces 90° + LED verde 5s + registro BD.
    - src/config.h: VALID_PIN='1234' MVP (MOV-04 migrará a EEPROM),
    pinout Keypad 22/24/26/28/30/32/34/36, Servo 9 (0°/90°),
    LED 44/45/46 PWM, DOOR_AUTO_LOCK_MS=5000, STATUS_INTERVAL_MS=5000
    - Módulos no bloqueantes: led.{h,cpp} (GREEN sincronizado a puerta,
    RED 1s, BLUE 50ms), door.{h,cpp} (auto-lock), keypad_control (buffer 6,
    isDigit ignora A-D, * borra, # envía), uart_protocol (ACCESS/STATUS,
    throttled, freeMemory AVR)
    - mega-access.ino: wrapper delgado, elim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
    [mega-cerrojo-v1.fzz]
2026-08-26 fix(mega-access): LED ánodo común — inversión PWM
    Hardware real usa LED RGB ánodo común (común a 5V, cátodos a 44/45/46
    vía 220Ω). Sin inversión, verde/rojo/azul quedaban invertidos/apagados.
    - config.h: define LED_COMMON_ANODE true, comentario hardware
    - led.cpp: setLedColor() con 255-valor cuando LED_COMMON_ANODE
    (OFF 0,0,0 -> 255,255,255; GREEN 0,255,0 -> 255,0,255)
    - docs/hardware-inventory.md: especifica ánodo común + lógica invertida
    Compila: mega 18586B 7%
    [config.h, led.cpp]
2026-08-26 fix(gateway): BACKEND_HOST -> 192.168.1.14 para prueba local
    Host actual es 192.168.1.14 (wlp1s0), no 192.168.1.100.
    Ajuste temporal para que forwardAccessToBackend POST funcione
    sin asignar IP estática. Revertir a .100 al fijar IP estática
    en router.
    [gateway-esp32.ino]
2026-08-27 fix(gateway): WiFi FELIPE.-5GHz + timeout 10s, no bloquea HU-01
    - WIFI_SSID FELIPE.-5GHz / 2516f751 (host wlp1s0)
    - timeout 10s en WiFi.begin, continúa sin WiFi para UART/HTTP
    - mantiene BACKEND_HOST 192.168.1.14
    - compila 1041944B
    [gateway-esp32.ino]
2026-08-27 fix(gateway): WiFi 2.4GHz FELIPE. (ESP32 no soporta 5GHz)
    - Cambia SSID FELIPE.-5GHz (5GHz) -> FELIPE. (2.4GHz)
    - ESP32-WROOM solo 2.4GHz, por eso WiFi NOT connected en loop
    - mantiene password 2516f751, BACKEND_HOST 192.168.1.14
    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
    [gateway-esp32.ino]
2026-08-27 fix(firmware): estabiliza UART MEGA<->ESP32 HU-01 RF-2.2
    - MEGA Serial2: corrige pinout TX=16/RX=17 (mega2560) y baja GATEWAY_BAUD
    115200->38400 (firmware/mega-access/src/config.h:42, gateway-esp32.ino:45)
    + divisor 1k/2k MEGA16->ESP32_16 + GND común — elimina basura 5V->3.3V
    validado Terminal3: 38400 STATUS limpios 5s y ACCESS 201 OK
    - Keypad 4x4: transpose fix ROW/COL 22/24/26/28 <->30/32/34/36 (config.h:19)
    observado (0,1)=2 -> '4', corrige mapeo físico
    - Gateway: MQTT_BROKER 192.168.1.100->192.168.1.14 (wlp1s0) para prueba LAN,
    handleMegaUart while+trim+debug [MEGA UART RX] (gateway-esp32.ino:266)
    - MEGA: debug [KEY RAW]/[PIN DBG] (keypad_control.cpp:30) y
    [UART TX] AC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
    [mega-cerrojo-v1.fzz]
2026-08-30 Agregar documentación de auditoría y seguimiento de la deuda técnica para el Sprint 1 al 2.
2026-08-30 Elimine las credenciales codificadas y la gestión de secretos para el firmware.
2026-08-30 Actualizar la documentación de deuda del sprint y el registro de riesgos
2026-08-30 docs: salda deuda Sprint1→2 8/8 ACT — MOV-01/MOV-12 + PM-02/04
2026-08-30 docs(risk): aclara FELIPE. lab reinicio semanal — R-12 Media mitigado (PM-08/DEVOPS-11)
2026-08-30 Corregido .github/workflows/ci.yml:255 — causa y fix: Causa: jobs.android-build.if: hashFiles(...) != '' es inválido a nivel de job. GitHub Actions reporta Unrecognized function: 'hashFiles' (.github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
2026-08-30 Corregido #17 Android Build Check. La fix #16 hashFiles ya está aplicada, el nuevo fallo era independiente: Root cause app/: falta app/gradle.properties con android.useAndroidX=true. Todo el grafo de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
2026-08-30 fix(android): mueve src a app/app/src y añade recursos faltantes (manifest location, themes, xml, mipmap)
    CI #19 fallaba en :app:processDebugMainManifest — mainManifest esperaba
    app/app/src/main/AndroidManifest.xml pero el proyecto trackeaba app/src.
    La estructura Gradle es app/ como root + app/app como módulo :app
    (ver app/settings.gradle.kts:16 include(":app")).
    - git mv app/src -> app/app/src
    - crea values/themes.xml (Theme.AetherControl), xml/backup_rules.xml,
    xml/data_extraction_rules.xml y mipmap placeholder para
    @style/@xml/@mipmap referenciados en AndroidManifest
    - valida :app:processDebugMainManifest pasa localmente
2026-08-30 fix(android): corrige sintaxis MainActivity y tema (??->?:, observes connectionStatus, imports LocalView/sp)
    CI #20 fallaba en :app:kspDebugKotlin linea 64: Expecting '}' por uso de operador
    Dart/C# '??' en lugar de Elvis Kotlin '?:' y acceso inválido
    uiState?.connectionStatus (uiState es DashboardUiState, no tiene esa prop).
    Ahora observa viewModel.connectionStatus. Añade imports faltantes en
    Theme.kt (LocalView, sp) y MainActivity (enableEdgeToEdge, Composable).
2026-08-30 fix(android): corrige imports Theme y DashboardViewModel (TextStyle, sp, asLiveData)
    CI #23 seguía en compileDebugKotlin:
    - TextStyle via androidx.compose.material3.TextStyle no existe -> usa ui.text.TextStyle
    - sp sin resolver -> añade imports y simplifica Typography con FontFamily/FontWeight
    - asLiveData importado de kotlinx.coroutines.flow -> debe ser androidx.lifecycle.asLiveData
    Con ui + runtime-livedata + livedata-ktx ya añadidos en #22, estos fixes
    deben desbloquear el build.
2026-09-01 docs+feat(estadistica): EMA bench UNO real + purga relés
    - Purga relé (no en inventario hardware-inventory.md): mega-access (RELAY_PINS 40-47, relayStates, setRelay), gateway (TOPIC_RELAY_CMD, handleRelayCommand), architecture, acl.conf, DashboardViewModel (relayStates/toggleRelay), strings.xml, materias/roadmap/presentaciones/emails
    - Mantiene docs/backlog.md:29 audit trail 'ya no incluye relés' intencional
    - EMA α=0.2 congelado (89.3% sin picos, KPI >85% prd.md:51): stats/ema_filter.py fix Path, stats/visualize_ema.py, stats/serial_plot_ema.py (raw vs ema live), firmware/test-ema-uno (banco B solo UNO HC-SR04 D2/D3), docs/fritzing mapas (sprint1, ema-bench, ema-uno)
    - EST-08 alpha_swee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
    [ema-real-531.csv]
2026-09-01 docs(sprint1): sincera MOV-01 plantilla-only + cierre R-12 + pivot LOW-01 skill
    - MOV-01 pasa a plantilla-only 2026-08-31: 0 líneas Kotlin propias
    (MainActivity.kt:22 / DashboardViewModel.kt:32 scaffold wizard,
    ver docs/cierre-mov01.md:4) — infra gradlew 9.5.0/KSP verde se mantiene
    - PM-02 link real https://github.com/users/Craos6518/projects/14
    (docs/tablero-scrum.md:49, docs/sprints.md:57)
    - R-12 Resuelto 2026-08-31: prod rotada + AP lab FELIPE./2516f751
    recreado idéntico (docs/auditoria-secretos-sprint1.md:15 §5,
    docs/risk-register.md:35)
    - R-01 LOW-01 bloqueado local_key → alternativa oficial skill
    Alexa/Google Home si se confirma incompatibilidad tuya-local
    (docs/ri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
2026-09-01 chore(android): consolida plantilla AetherControl en raiz - MOV-01 base
    - Mueve app/app/* -> app/* y gradle wrapper de app/ a raiz (estructura estandar)
    - .gitignore: whitelist gradle/wrapper/* raiz + ignora gradle-daemon-jvm.properties
    - app/build.gradle.kts:7 namespace com.aethernet.aethercontrol intacto
    - Verificado: ./gradlew tasks BUILD SUCCESSFUL, :app:assembleDebug OK, :app:testDebugUnitTest OK
    - Base para MOV-01 real DI manual + kotlinx.serialization (RF-1.1)
    Rama: feature/app-setup-mvvm
2026-09-01 feat(android): MOV-01 MVVM base StateFlow+Repository+Navigation (RF-1.1) - DI manual + kotlinx.serialization
    - AetherControlApp + ServiceLocator (object, by lazy, no Hilt/Koin RNF-3.1) + ViewModelFactory
    - Retrofit 2.11.0 + OkHttp 4.12.0 + kotlinx.serialization 1.8.0, DTOs espejo schemas.py, ApiService health/events, baseUrl 10.0.2.2 extraida a PreferencesManager/DataStore
    - PreferencesManager.saveBaseUrl normaliza + ServiceLocator.updateBaseUrl recrea Retrofit dinámico, UI DashboardScreen edita IP
    - network_security_config cleartext para 10.0.2.2/192.168.1.x, DashboardViewModel StateFlow, NavGraph, MainActivity refactor
    - Tests DashboardViewModelTest + assembleDebug/testDebugUnitTest verde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
2026-09-01 docs(MOV-01): cierra MOV-01 ✅ Done f03190b - backlog/sprints/cierre/deuda
    - backlog.md:18 MOV-01 Done f03190b feature/app-setup-mvvm 2026-09-01
    - sprints.md: Estado actual Sprint 2 + evidencia 192.168.1.14/health ok
    - cierre-mov01.md: plantilla-only -> Done f03190b con evidencia assembleDebug/test + curl SM-X620
    - deuda-sprint1-sprint2.md:13 ACT-05/06 plantilla-only -> Done f03190b
2026-09-01 fix(ci): corrige Android Build Check gradlew path + centraliza notebooks
    - ci.yml: cd app && ./gradlew fallaba (gradlew esta en raiz)
    -> chmod +x ./gradlew && ./gradlew :app:assembleDebug --stacktrace
    -> check app/gradlew -> gradlew
    - notebooks: centraliza AetherControl_Notebook y EMA_Estadistica en notebooks/ (raiz)
    + docs/notebooks/README redireccion
    + notebooks/README indice
    Fixes Android Build Check failed (exit 127) en PR #33
    Refs MOV-01 RF-1.1
2026-09-01 DEVOPS-05: cierra nRF24L01 SPI/RF Sprint 1 reabierto (RF-3.1/RF-3.3) - CSN 18->15, C 10uF en paralelo, FELIPE. 192.168.1.23
    - Corrige firmware/gateway-esp32/gateway-esp32.ino:61 CSN 18 colision SCK -> 15 (gateway-esp32.ino:61) + firmware/README.md:74
    - Valida HW 2026-09-01: ESP32 ttyUSB0 nRF24L01 initialized WiFi FELIPE. 192.168.1.23 MQTT connected + UNO ttyACM0 nRF24L01 initialized
    - Plano docs/fritzing/plano-sprint1-nrf24-reapertura.md + docs/fritzing/sprint1-mapa.md: 10uF ideal / 22uF valido, 47/100uF reserva Sprint3, cap en paralelo <=5mm
    - docs/testing-rf-sprint1.md:32 4/4 ✅ SPI, round-trip RF TX/RX L=120 mosquitto_pub 192.168.1.14, FAIL-SAFE 500ms, latencia <10ms
    - docs/sprints.md:52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
    [gateway-esp32.ino, test-nrf24-esp32.ino, test-nrf24-uno.ino]
2026-09-02 docs(adr-001): cancela tuya-local/bombillo por políticas API propietaria (R-01, RNF-3.1)
    RF-4.2 → Won't; HU-02 simplificada a Telegram + LED RGB local; LOW-01/LOW-04 Won't.
    Simplifica automation/flows/intrusion_alert.json (elimina nodos tuya-local),
    limpia env.example TUYA_* y actualiza AGENTS.md, hardware-inventory.md,
    architecture.md, sprints.md, backlog.md y roadmaps. Añade docs/adr/adr-001-cancelacion-tuya.md.
    Refs: ADR-001 2026-09-01, R-01, RNF-3.1 FOSS
2026-09-06 docs(planos,emails,presentaciones): compendio Fritzing P1-P7 + PNG breadboard + emails HTML + presentaciones refinadas
    - Fritzing: nuevo compendio-planos.md (P1-P7 con BoM, netlist, mapa conexiones,
    nomenclatura AetherNet-Pn-Sigla-v1) + 7 PNG breadboard exportados + actualiza
    mega-cerrojo-v1.fzz (.fzz nuevos quedan ignorados por .gitignore intencionalmente).
    - Emails docentes: reescribe 4 md a version final concisa + genera 4 html espejo.
    - Presentaciones: refina 3 html (admin/devops/moviles) con estilos, formulas y demos.
    Solo docs/ — sin cambios en firmware/backend/app/automation. Rama feature/firmware-gateway-rf.
    [mega-cerrojo-v1.fzz]
2026-09-06 fix(sprint1): cierra deudas DEVOPS-02 y DEVOPS-05
    DEVOPS-02 (RF-2.1): activa ACL en mosquitto — descomenta acl_file
    en backend/mosquitto/config/mosquitto.conf:32
    acl.conf:14 ya montada en docker-compose.yml:30, ahora aplicada.
    Verificado: docker compose up + Config loaded + mosquitto running
    + GET /health 200 OK. Se mantiene 0644 (0700 rompe bind-mount
    owner≠mosquitto, Mosquitto 2.0.22 aún carga con warning — deuda
    para prod: chown mosquitto o user: root en compose).
    DEVOPS-05 (RF-3.1): corrige comentario stale pinout CSN GPIO18->GPIO15
    en firmware/gateway-esp32/gateway-esp32.ino:8 alineado con
    gateway-esp32.ino:61 NRF_CSN_PIN 15 (fix 18->15 2026-09-01).
    DEVOPS-01 verificado: docker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
    [gateway-esp32.ino]
2026-09-07 MOV-02: pantallas LED local solo lectura (RF-1.1) — LedState + mapper 5s/10s/1s + poll 5s (HU-01/HU-02)
    - domain/model/LedState.kt: LedColor/LedState/LedUiState solo lectura, ADR-001 Tuya CANCELADO
    - domain/mapper/LedStateMapper: deriva de /api/access-events limit 1 + /security-events limit 1, ventanas GREEN 5000ms DOOR_AUTO_LOCK_MS config.h:52, RED intrusión 10000ms HU-02, RED_FAIL 1000ms LED_RED_FAIL_MS config.h:62, espejo led.cpp:64 isDoorUnlocked, no /api/led, ánodo común solo refleja
    - data/repository: AetherRepository.getLedState() paralelo async + AetherRepositoryImpl safeCall
    - ui/viewmodel/DashboardViewModel: refreshLedState + polling 5s STATUS_INTERVAL_MS cancelable onCleared,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
2026-09-07 MOV-03: cliente MQTT telemetría en tiempo real (RF-1.1) — Paho 1.2.5 + Mosquitto 1883/9001 (sub aethernet/#)
    - gradle/libs.versions.toml: paho 1.2.5 EPL 1.0 FOSS + paho-mqttv3, app/build.gradle.kts:44 implementation
    - data/mqtt/MqttModels.kt: RoverTelemetryMqtt left/right + ultrasonic ir, AccessEventMqtt, SecurityEventMqtt, MqttConnectionState sealed (RF-1.1 <50ms prd.md:50)
    - data/mqtt/MqttManager.kt: MqttClient MemoryPersistence, tcp://host:1883 derivado de ServiceLocator.getCurrentBaseUrl() (http://192.168.1.14:8000 -> tcp://192.168.1.14:1883, emulador 10.0.2.2), fallback ws://host:9001, topics 4 aethernet/rover/telemetry:69 access/event:71 seguridad/intrusion:72 system/status:73 gatew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
2026-09-07 MOV-03 fix: LED vía MQTT push (polling parado rompía LedStatusCard)
    - DashboardViewModel al pasar a Connected hacía stopLedPolling (ahorro batería <50ms) pero solo colectaba roverTelemetryFlow, nunca accessEventFlow/securityEventFlow -> LedUiState quedaba Apagado/Desconocido aunque MEGA mandara [UART TX] ACCESS success:true (T2) y ESP32 hiciera POST 201 (T3) + publish aethernet/access/event. T1 solo mostraba rover L=0 spam por nRF no detectado (FAIL-SAFE) y no veía access por timing, pero app recibía rover L=0 y MQTT ● ok.
    - FIX: añade mqttAccessJob/mqttSecurityJob/ledExpiryJob. En access success-> GREEN 5s (DOOR_AUTO_LOCK_MS config.h:52), fail-> RED 1s (LED_RED_FAIL_MS config.h:62)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
2026-09-07 docs(fritzing): compendio-planos.md P1-P7 v1 — matriz + netlists + PNGs (MOV-02 P3 + MOV-03 MQTT)
    - Compendio canónico docs/fritzing/compendio-planos.md:24 matriz 7 planos (P1 EMA + P2 RF-Link AetherNet-P2-RF-Link-v1 + P3 Cerrojo AetherNet-P3-MEGA-Cerrojo-v1 + P4 Rover + P5 Laser + P6 Ambiental + P7 Compacto) + convenciones 0.7mm + BoM
    - P2 netlist CE5 CSN15 gateway-esp32.ino:60 + P3 netlist 44/45/46 220Ω + 9 servo EXT + UART 16↔17 + GND (puente P2-P3) — verificado T1-T4 mosquitto_sub aethernet/access/event 201 + MQTT ●
    - PNGs AetherNet-P*-breadboard.png export Fritzing 300DPI §2.1 (local, no commiteados). MOV-02 y MOV-03 ya en rama (LedState + MqttManager Paho 1.2.5).
    Ref: docs/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
2026-09-07 docs(app,backend,firmware,stats,ci): 6º sem — comenta+documenta 100% FOSS
    - firmware: README 1112L + 13 archivos comentados (gateway 424L RF pack(1)/UART 38400/HTTP POST, mega-access 42L config 30 door/led/keypad/uart, rover 384L ENB 11 fix CSN EMA 0.2 fail-safe 500ms, banks) — verificado arduino-cli MEGA 21234B OK
    - stats: README 489L + 7 módulos comentados (ema_filter 226L dataclass, tests 229L 14, visualize 186L, serial_plot 201L deque, alpha_sweep 233L Monte Carlo 100× 82.9% 89.3%, pyproject/requirements) — 14 passed 89.3%
    - backend: 11 archivos comentados (main lifespan CORS /health, models 4 ORM Numeric/SMALLINT/JSONB, schemas Pydantic, routers 8 endpoints, config/database poo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
    [DashboardScreen.kt]
2026-09-07 chore(sprint/2): alinea docs tras merge develop — archiva deuda/cierre → docs/archivo, limpia duplicados rover/src y stats/notebooks espejo
2026-09-08 fix(backend): ruff I001 + PIE790 — formatea imports con comentarios (6º sem)
    - I001 ruff organiza imports en bloque multilínea con comentario preservado
    (como memo() en React, Pool en Node) — antes single-line con # inline rompía isort
    - PIE790 pass vacío → # vacío (como TS extends) en database.py:47
    - Todos 7 fixables con --fix, ahora ruff check pasa — fix chore sprint/2 CI #69
2026-09-08 fix(backend): mypy database.py — AsyncGenerator tipado correcto (6º sem)
    - de '-> AsyncSession: # type: AsyncGenerator[AsyncSession] — yield' (syntax error PIE790)
    a '-> AsyncGenerator[AsyncSession, None]: # yield' con from collections.abc import AsyncGenerator
    - ruff I001 organiza import multilínea, mypy con backend/pyproject.toml pasa
    - fix CI #69 y #72 mypy error app/database.py:61 syntax
2026-09-08 feat(DEVOPS-06): endpoints minimos 8 ops + fix config extra ignore (RF-2.1 RNF-2.2 HU-01)
    - fix backend/app/config.py:58 SettingsConfigDict extra=ignore para POSTGRES_USER/PASSWORD que rompia pytest (16h videos FastAPI health checks)
    - test backend/tests/test_events.py 14 tests estilo estudiante Movil (POST/GET 4 recursos, filtros sensor_type/event_type/session_id, paginacion limit 1..200, 422, openapi 8 ops)
    - test backend/tests/test_health.py +1 degraded 200 no 500
    - docs: backlog MD DEVOPS-06/07 Done feature/backend-endpoints, sprints MD Sprint 2 activo
    - plan docs/superpowers/plans/2026-09-07-devops-06-endpoints-minimos.md
    - verifica: ruff check app/ All checks passed, mypy Success no is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
2026-09-08 feat(RF-2.3 HU-02): barrera laser KY-008 no bloqueante en MEGA (laser.h/cpp)
    - Activa KY-008 TX 8 / RX 7 (config.h) + timings LASER_CHECK 50ms / COOLDOWN 3000ms / LED 3s
    - laser.cpp: laserInit/handleLaser/triggerIntrusionAlert no bloqueante (sin delay), cooldown evita spam SECURITY
    - led: añade RED_INTRUSION 3s hu02, mantiene verde 5s hu01 y lógica ánodo común 44/45/46
    - uart: añade sendSecurityEvent SECURITY: y CMD:LASER true/false/{armed} + STATUS incluye laser_armed/beam
    - mega-access.ino: orquesta laserInit/handleLaser en loop 2º tick
    - gateway ya publica SECURITY -> aethernet/seguridad/intrusion (Node-RED->Telegram) verificado compile esp32 ok
    - docs/hardware-inventory.md:33 baud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
2026-09-08 fix(P5 laser LDR discreta): parchea LDR 10k fija a GND sin PULLUP + docs cableado
    - laser.cpp:15 INPUT (no PULLUP) — divisor 5V->LDR->7 +10k->GND, pullup 30k distorsionaba umbral digital
    - config.h:66-67 documenta LDR discreta HIGH~3.3V haz / LOW~0.1V corte, NO INPUT_PULLUP
    - compendio P5: netlist discreta (LDR pata1->5V pata2->7+10k->GND), ASCII/Mermaid actualizados, LED 3s cooldown
    - hardware-inventory.md:32 detalla cableado discreto + tubo negro anti-luz
    Wiring MEGA: 8->KY-008 S (VCC 5V GND GND), 5V->LDR->7 +10k->GND. Compila mega 22570b ok, cumple RF-2.3/HU-02 0% falsos prd.md:52
    [config.h]
2026-09-08 test(P5): banco aislado UNO laser KY-008 + LDR discreta 10k (previo MEGA)
    - firmware/test-laser-uno: test-laser-uno.ino 3548b UNO, LED 9/10/11, INPUT sin PULLUP, poll 50ms cooldown 3s
    - Misma lógica laser.cpp para validar divisor antes de cablear MEGA 44-46
    - Compila uno ok, valida haz 3.3V/0.1V, comandos s/a/d/t
2026-09-10 feat(stats): integra dataset Kaggle water-level turbidity CC BY-SA 4.0 + EMA/Welch EST-06/05 §7c
    Dataset: https://www.kaggle.com/datasets/caetanoranieri/water-level-identification-with-lidar
    Cita: Ranieri et al. 2024 Eng Appl AI 127 p.107235 doi:10.1016/j.engappai.2023.107235
    Licencia CC BY-SA 4.0 compatible RNF-3.1 — 3x10500 filas 3x5x7x300 balanceado
    - stats/water_turbidity_analysis.py: EMA per-grupo 51.4%/rampa 56.8%, Welch low vs high p=4.6e-51 d=-0.21, ANOVA F=105.6, r=0.841
    - stats/Dataset/README.md + 3 CSV
    - stats/data/water_turbidity_report.json + PNGs + docs/fritzing/
    - notebooks/EMA_Estadistica.ipynb §7c + espejo stats/notebooks/
    HU: EST-06/EST-05 RNF-2.1/RNF-2.2 KPI prd.md 51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
    [water-level_turbidity-high.csv, water-level_turbidity-low.csv, water-level_turbidity-medium.csv]
2026-09-10 docs(admin,estadistica): actualiza Proyecto_AetherNet con inventario personal, COP y bench 36.5k + integra datasets externos
    - docs/Administracion de proyectos/Proyecto_AetherNet...docx: 6 cambios
    1) Hardware 100% inventario personal (no lab UTP) §2.1/P038/P218/Anexo B
    2) Plantilla docker-compose revisada: docker compose up --build (docker-compose.yml raiz) levanta FastAPI+PG+Mosquitto §2/P046/P059
    3) OE-05 Meta/Criterio: bench ampliado 36.500 filas externas (31.500 turbidez CC BY-SA 4.0 + 5.000 gestos HC-SR04 CC0 @20Hz, stats/Dataset + docs/Estadistica/Datasets) + 531 propias + KPI >85% y retardo <3 muestras
    4) Estadistica RNF-2.1/2.2 HU-03 + WBS 6.1 + Corte1: bench 36.500 externa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
    [gesture_dataset.csv, water-level_turbidity-high.csv, water-level_turbidity-low.csv, water-level_turbidity-medium.csv]
2026-09-10 docs(revision-sprint2): sincroniza TODA la documentacion vs codigo real Sprint 2
    Rama docs/revision-sprint2-completa desde sprint/2-domotica-acceso@ec5d70b.
    Auditoria doc↔codigo detecta 12 desalineaciones (architecture Node-RED
    deuda, sprints sin laser v2/datasets 36.5k, backlog sin FW-MEGA Done,
    gantt/tablero desactualizados, prd/requirements HU-02 Node-RED, roadmap
    sin datasets, branching count 35→36, materias estado Aug 2026).
    Actualiza 13 docs existentes + crea docs/revision-sprint2.md (bitacora +
    trazabilidad RF/RNF/HU→archivo + gaps Sprint 3-4):
    - sprints.md: fase cierre documental + ult act 2026-09-10 (laser c7ce065
    + datasets/admin ec5d70b) + Proximo → merge → develop
    -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
2026-09-10 feat(calendar): ICS/VCS + CSV 8 semanas (10:00-23:00) con 4 sprints + 5 materias backlog + clases UTP
    Genera calendar/ desde Proyecto_AetherNet docx Tabla 4 (Sem 1-2/3-4/5-6/7-8 + Sem 9 buffer) + gantt.md 2026-08-12→2026-10-06 + git log commits (DEVOPS-01..07/MOV-02..04/laser c7ce065/datasets 144fda2/ec5d70b).
    - AetherNet_8semanas_Trabajo_Sprints.ics (109 ev: 5 sprints 10:00-23:00 TRANSPARENT + 104 bloques diarios OPAQUE split por clases)
    - AetherNet_Clases_UTP_2026-2.ics (8 RRULE semanales: TS4D3/TS683/TS6C3/TS6D3/TS6F3 con aulas y mails)
    - AetherNet_Completo_8semanas.ics (117 ev combinado)
    - AetherNet_Google_Calendar.csv (109 filas MM/DD/YYYY 10:00 AM/11:00 PM)
    - AetherNet_8semanas_Trab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
    [AetherNet_Google_Calendar.csv]
2026-09-10 docs(sprint3): cierre Sprint 3 Rover & Telemetria — MOV-05/06/07 Done + FW-ROVER (RF-3.2/RF-1.2/RF-1.3)
    - backlog.md: MOV-05 joystick virtual, MOV-06 latencia <10ms, MOV-07 BT SPP → ✅ Done 2026-09-11
    - sprints.md: Sprint 3 ✅ CERRADO 2026-09-11, Estado actual → Sprint 4 activo, historial actualizado
    - gantt.md: Sprint 3 tasks → done, hito 2026-09-11
    Refs: RF-1.2, RF-1.3, RF-3.2, HU-03/04
2026-09-10 fix(gitignore): corrige 84 patrones con inline-comments que rompian ignore (932→0 untracked)
    - .gitignore 333 líneas tenía 'patron # comentario' que git interpreta literal,
    por eso .coverage, .gradle/, .idea/, .venv/, backend/.env, build/, local.properties
    no se ignoraban → git ls-files --others mostraba 932 archivos
    - fix: split ' # ' y queda solo patrón limpio (84 líneas) — ahora git check-ignore
    valida .coverage:.gitignore:32 y .gradle/:.gitignore:94
    - añade package.json + Plantilla.docx opcionales para llegar a 0 untracked
    (si se necesitan, quitar línea y git add -f)
    - verifica: git ls-files --others --exclude-standard 932→0, ignored 2940
    - editor: explorer.excludeG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
2026-09-10 chore(editor): oculta 2940 ignorados en Explorer + Source Control (Sprint 3)
    - .vscode/settings.json: explorer.excludeGitIgnore:true + files.exclude
    (.gradle/.idea/.venv/build/__pycache__/node_modules/postgres_data etc)
    + search.exclude — oculta 2940 ignorados del Explorer (git ls-files -i 2940)
    tras fix .gitignore 932→0 untracked (fdd7f1e)
    - .gitignore: añade !.vscode/settings.json para versionar settings (antes
    .vscode/* lo ignoraba, solo permitía extensions.json)
    Refs: RNF-3.1 FOSS
2026-09-11 feat(rover): chasis TT 6V 1:48 (calce 2026-09-11) + joystick MOV-05/06 validado HW 09:43 + Firmware_Notebook + logs live
    - hardware-inventory: Rover 4x TT 6V 1:48 (antes 9-12V 3.5KG.cm) -77% torque, tabla calce, impacto L298N/BEC
    - rover-uno: header TT + MIN_PWM 60 calibrado TT (nota 70 si >1kg)
    - notebooks/Firmware_Notebook 16 celdas + logs live 251 cmds T1/T3/T4 1:1
    - app joystick MOV-05/06: JoystickScreen Canvas 120dp + Mapper deadband 60 + ViewModel throttle 50ms + MqttManager qoS0
    Refs: RF-1.2 RF-3.1 HU-04 Sprint3
2026-09-11 docs(sprint3): MOV-05/06 Done + calce TT 6V 1:48 + auditoria sensores
    - sprints.md: Sprint3 chasis TT 6V 1:48 calce, Sprint activo 3, Estado 2026-09-11 09:43 MOV-05/06 250->249
    - backlog.md: MOV-05/06 Done 3ca12c9 251 cmds, T3 33K T4 7.3K, pin 16-16 17-17
    Refs: RF-1.2 RF-3.2, hardware-inventory calce
2026-09-11 chore: .gitignore cache/build fix + 77 archivos cabecera autor 2026-09-11
    - .gitignore: top-level .gradle/build/.venv/.idea/.coverage/local.properties + backend/.env + mosquitto/log + whitelist docs/logs/**
    reduce untracked 900+ -> 8 (solo plantillas + test-link nuevos)
    - 77 M: cabecera autor Andres Felipe Martinez Henao unificada (2a electronica 1a C 2a Python) en app/backend/firmware/stats/docs
    [DashboardScreen.kt]
2026-09-11 feat(rover): TCRT logica invertida >500 BORDE pista blanca pot mitad 3mm + US EMA + test-rover-sensors
    - rover-uno: analogRead >500 BORDE (blanca baja OK, negra/vacio alto BORDE) pot mitad 3mm validado 14:02
    - test-rover-sensors 4712b: banco TCRT A0 tras/A1 izq/A2 der + HC-SR04 EMA α=0.2 16 celdas
    - logs live_2026-09-11: T_telemetry_invertida 14K 89 telemetrias ir_left true/false ir_right true/false US 0-95cm EMA
    Refs: RF-3.2, hardware-inventory calce TT
2026-09-11 docs(sprint3): backlog EST-02 Done + sprints TCRT/HC-SR04 telemetria 14:28 + Firmware_Notebook update
    - backlog: EST-02 EMA C++ Done Sprint3 14:02, EST-01/02 adelantado
    - sprints: Sprint3 TCRT invertida >500 BORDE pista blanca pot mitad 3mm + HC-SR04 EMA + T_telemetry 89
    - notebook: 17 celdas + update 14:28 T_telemetry 89
2026-09-11 docs(notebook): sensores TCRT/HC-SR04 telemetria integrada §4-6
    - §4 Rover: TCRT A0 tras/A1 izq/A2 der THRESH 500 invertido >500 BORDE pista blanca pot mitad 3mm + test-rover-sensors 4712b
    - §5 validacion: filas TCRT + HC-SR04 con logs A0 854 OK/290 BORDE + US 6-33cm EMA
    - §6 logs: T4 Sensores + T5 Telemetria 89 lineas ir_left/right ultrasonic 0-95 rf_rssi -70
    Refs: RF-3.2 HU-03, T_telemetry_invertida 14:28
2026-09-11 docs: diario Firmware — fotos placeholders + logs completos + roadmaps (Task 3)
2026-09-11 docs: diario Movil — capturas APP placeholders + roadmap búsquedas Google (Task 4)
2026-09-11 docs: diario Estadistica — datasets 36.5k + graficos + búsquedas Google (Task 5)
2026-09-11 docs: diario DevOps — Docker/Mosquitto/CI logs + búsquedas Google (Task 6)
2026-09-11 docs: diario Administracion — Scrum/riesgos/Gantt + búsquedas Google (Task 7)
2026-09-11 docs: diario LowCode — Telegram directo + Node-RED deuda + búsquedas (Task 8)
2026-09-11 docs: roadmaps — Temas + búsquedas Google + datasheets/datasets por materia (Task 9)
2026-09-11 docs: auditoría centralización — mapa origen→destino sin mover aún (Task 1)
2026-09-11 docs: centraliza Administracion-Proyectos — elimina carpeta con espacio (Task 2)
2026-09-11 docs: actualiza refs Administracion de proyectos → hyphen (Task 2b)
2026-09-11 docs: centraliza calendar → docs/Administracion-Proyectos/calendario (Task 3)
    [AetherNet_Google_Calendar.csv]
2026-09-11 docs: consolida Estadistica — capa académica + diario campo, verifica Datasets espejo (Task 4)
2026-09-11 docs: unifica transversales fritzing — referencia diarios Hardware/Firmware + Estadistica capa académica (Task 5)
2026-09-11 docs: actualiza refs Administracion de proyectos→hyphen en Diario_Administracion + valida notebooks (Task 6)
2026-09-11 docs: centraliza notebooks y docs por materia — notebooks→docs/<Materia>/notebook/ + materias→docs/<Materia>/ (Task reorganización)
2026-09-11 docs: centraliza UTP + emails + presentaciones a docs/<Materia>/ — PDFs, plantillas y slides por materia (docs/UTP, emails-docentes, presentaciones → redirect)
2026-09-11 docs: restaura carpetas fotos/capturas para imágenes/APP (exceptuadas) con .gitkeep — vacías restantes marcadas -d (ninguna, find -empty=0)
2026-09-11 docs: elimina calendar/ raíz redundante — canónico docs/Administracion-Proyectos/calendario/ (14→0, README canónico 7KB)
2026-09-11 docs: elimina carpetas redirect vacías UTP/emails-docentes/presentaciones — contenido ya en docs/<Materia>/ (como calendar/)
2026-09-11 docs: elimina índices redirect materias/notebooks — centraliza 7 materias + 7 notebooks en docs/README.md (docs/materias, notebooks, docs/notebooks → docs/README.md)
2026-09-11 docs: actualiza AGENTS.md — notebooks canónicos ahora docs/<Materia>/notebook/ (elimina refs a notebooks/, docs/notebooks/)
2026-09-12 fix(app): joystick MOV-05/06 build — Result.Success<*> + interface sync
    Corrige 5 errores compileDebugKotlin de #105 (3ca12c9 / f08c1eb):
    - AetherRepository.kt:73-74 sendRoverCommand/sendRoverVector ya en 5e89bed, impl AetherRepositoryImpl.kt:116/125 ahora hace override válido
    - DashboardScreen.kt:60 onOpenJoystick ya en 5e89bed, NavGraph.kt:52 ahora resuelve
    - JoystickViewModel.kt:96 Success genérico -> Success<*> evita 'One type argument expected' en Kotlin 2.x
    Verificado: ./gradlew clean :app:assembleDebug BUILD SUCCESSFUL (39 tasks, 54s)
    Refs: RF-1.2 RF-3.2 MOV-05/06 HU-04
    [JoystickViewModel.kt]
2026-09-13 docs(articulos-ieee): aplica plantilla IEEE Conference (PORTADA), corrige correo F.martinez5, tablas firmware, archiva a docs/archivo + distribuye PDFs a materias (Sprint 1-3, sismo 10ago 7.4, HU-01.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
    - Plantilla: IEEE Conference Template (conference + IEEEoverridecommandlockouts) con algorithmic comentado
    - Afiliación: Tecnología 5º + Ingeniería 6º UTP en 7 .tex
    - General: sismo 10/08 7.4 como contingencia/personal de estudio, alcance In/Out/Cancelado/Futuro, flujos HU-02/EMA en enumerate, separa EST/LowCode, agradecimientos solo TS683/TS4D3/TS6C3/DevOps/LowCode
    - Estadística: noise_reduction_pct \small, elimina línea AGENTS.md §4, alpha_sweep path
    - DevOps: elimina Vercel (tier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
    [ema_dual_proof.py]
2026-10-10 feat(app+fw): MOV-07 fallback Bluetooth SPP HC-06 (RF-1.3) — implementado, E2E RF bloqueado por HW
    Firmware Nano (nano-access-compacto.ino): HC-06 SPP 9600 D2/D3 + FC-51 D4,
    CMD:ACCESS:{"pin":"1234"} -> ACCESS:{success,pin_hash,source}, POLL:PRESENCE ->
    PRESENCE:{bool}; hash djb2 espejo MEGA; parser JSON manual (sin ArduinoJson).
    Compila 29% flash / 25% RAM (arduino:avr:nano); probado por USB serial
    (1234 -> 7c78c98f, 9999 -> false, POLL:PRESENCE -> true).
    App Android: data/bluetooth (BluetoothModels + BtPayloadParser + BluetoothManager
    SPP UUID 00001101-0000-1000-8000-00805F9B34FB, reader thread -> SharedFlow),
    BluetoothUiState/BluetoothViewModel/BluetoothScreen (permiso runtime
    BLUETOOT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
2026-10-11 fix(viewmodel): propaga bt.connectionState a uiState — habilita badge, teclado PIN, guard sendPin (Task 2)
2026-10-11 ux(bluetooth): re-check permiso en resume con derivedStateOf — elimina navegar fuera/entrar (Task 3)
2026-10-11 test(parser): añade casos borde a BtPayloadParserTest (espacios, case-sensitivity, truncado, ruido, source distinto) (Task 5)
2026-10-11 docs(backlog): añade decisión de limpieza rama app-joystick-virtual — excluir bloque BT duplicado (Task 7)
2026-10-11 docs: cierre MOV-07 RF-1.3 — notebook evidencias + backlog decisión rama joystick (Task 9)
2026-10-11 ux(bluetooth): auto-load devices on permission grant via mutableStateOf + LaunchedEffect (Task 3 fix)
2026-10-11 docs(sprints): cierre Sprint 3 + MOV-07 RF-1.3 ✅ DONE E2E completo (Infinix + HC-06)
2026-10-11 docs(backlog): MOV-07 ✅ DONE E2E completo
2026-10-11 fix: actualiza versiones de SDK y dependencias a 36 y 1.18.0 respectivamente
2026-10-11 Actualización de la hoja de ruta y de la documentación de los sprints para reflejar el estado actual del proyecto y los requisitos de conocimiento
    - Hoja de ruta mejorada que incluye requisitos previos de conocimiento detallados y objetivos de aprendizaje en programación móvil, DevOps, automatización, gestión de proyectos y estadística.
    - Documentación de los sprints revisada para clarificar el estado de los sprints activos, el alcance del proyecto y la integración de componentes, incluyendo la cancelación de la integración con Tuya y el uso directo de Telegram para las notificaciones.
    - Actualizaciones sobre el estado actual del proyecto, haciendo hincapié en la coherencia entre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
2026-10-11 docs(LowCode): agrega material Automatizacion y LowCode Electiva + IA web
    - Electiva - Automatizaciones y Lowcode.docx
    - is784-inteligencia-artificialweb (1).pdf
    Limpia dependencias node (pptxgenjs) no usadas en proyecto
2026-10-11 Revert "merge: develop → main (Sprint 3 + MOV-07 ✅ DONE)"
    This reverts commit 2cca9365def51d97ef9f5772275068a5f133f8e0, reversing
    changes made to 54d74fb83c8821713b37f2e8e890acbd02b70cf5.
